iandchasse/silkscreen-enclosures/enclosures/OPEN-WORK.md

# Open work (as of 2026-10-21)

What is built but not printed, what is unproven, and the options that are studied but parked. The case READMEs have
the full records; the study notes named here are local (not in git).

## The slide-on cover (2026-11-01, round 3): checked in CAD, the phase-3 cover not printed

A reversible TI-84 style cover, one printed part per envelope (`enclosures/cover/`; `print/cover/`, `print/silkscreen-cover-plates.3mf`, a
**temporary** plate file with one cover per plate): on the front it carries the reader over the screen, on the back it stays on while
reading. Round 1's fit coupon A was printed and "feels fine" (Ian, 2026-11-01); round 2 added the Silkscreen logo engraved on the outer face
(with the two-colour switch, OFF), rounded edges, all four poses, no long stop wall (corner pieces only) and a scalloped side. Everything else
about it is **untested**: Ian printed the phase-2 cover ("the fit isn't quite there") and phase 3 answers that, but nothing of phase 3 is printed, and the snap forces are beam estimates. What Ian still decides or has to find out:
- **Putting the covers into the case plate files** (make_plates.py, every per-configuration project; not started: the worktree's `out/` lacks the other builds' print parts and the 4.26 pipeline cache is cold at its path; the cover-only plate file stays the temporary one until then);
- print one cover and check the fit, the click, the scallop's finger room, the rounded edges and (if wanted) the two-colour switch in the CC2's
  slicer (the CLI read-back is the only test so far);
- phase 2 (2026-11-01): the plate is solid over the screen (rest gap to the glass 1.37 mm; my estimate of the press that touches it: 155 N keyed, 98 N chinless, 225 N on the 3.68),
  two engraved border lines, a rounded-tongue tab inside phase 1's footprint, a uniform slit with a round end; no sharp edge is left on the covers but the engraving rims (logo and border lines);
  the cover gained about 4 to 6 g and 8 to 14 minutes for the solid plate and the lines;
- the scallop is limited by the screen (2.4 mm inset on the 4.26, 3.0 on the 3.68; 2.0 mm of plate stays past the screen opening): more would
  uncover display;
- the corner extensions are 4.7 mm (4.2 on the 3.68), set by the scallop's ease and the finger margin; a longer contact patch would shorten the ease;
- J6 is covered by the end wall in every pose (a window would have to be in the prong's zone one way up); the cover comes off to use it;
- phase 3 (2026-11-01, answering Ian's print of phase 2): the border is a rounded rectangle centring the logos; the room top to bottom (Y) at home is 0.234 mm (was 0.338) on the 4.26 and 0.165 mm on the 3.68 (channel walls 0.20 / 0.15 per side, corner pieces 0.14 / 0.12 off the arcs); the snap is firmer (pull-off peak +22 % by the beam model, push-on +6 %, drag +13 %).
  **Risk:** printing takes clearance off a gap (round 1's note: 0.1 to 0.3 per side, not measured), so the tighter fit may bind and need a pass with a file: the one number to move is `cy` in `enclosures/cover/model.py`;
- no Z clamp (0.70 mm of Z play, 0.709 measured);
- whether the site offers it (`print/SITE-BUILDER-NOTE.md` says not until a whole cover has been printed).

## Emily B's edit (2026-10-23): what Ian still decides

The six changes Ian took are in both cases (`case-426/README.md`, "Emily B's edit"). Left for Ian:
- **The side gate's 0.2 mm top chamfer.** It was drawn to end level with the old seam V (`GATE['top_chamfer']`, both cases) and
  was kept: it is a separate part and squaring it reprints the gate and touches the gate checks. Set it to 0 if he wants it square.
- **The two-colour logo switch** (2026-10-24; every lid carries the logo bodies as modifier parts, off by default; no separate
  files any more): whether the site tells its users about the switch (`print/README.md`, "Two-colour logo"); and the clicks in
  ElegooSlicer (the CC2's slicer), which are untested there (the OrcaSlicer 2.4 CLI reads the switch back; its GUI was not opened).
- **The pin tip at -1.00** (the plan said -0.90, a layer's mid-plane on the midplate's print; -1.00 is whole layers and lays where the
  barbs' tip laid).
- **Emily B's (mixmastermouse) questions:** which of the five side keys click on their lid (their nub cut-back, not taken); a photo
  of their bulge (their shorter lid posts, flat H5 pin and removed battery springs: a smaller version was taken on 2026-10-24, the
  4.26 lid's H2, H5 and H6 posts one layer short and the dead midplate spring at J6 dropped; `case-426/README.md`, "The lid's bulge
  and the board's posts"; model estimates, not measured on a print, so a photo of a real bulge still decides whether more is worth
  doing); their screws; and that their tub has the old USB edge. The credit is given (the READMEs name Emily).
- **Behind the bulge fix, on record, not done:** the midplate springs' 0.6 mm travel is narrower than the stack's tolerance window
  (every spring is free in the thinnest corner, the two lower strips bottom out on a thick panel with a thick print), and `usb_fit`
  puts the board on the H3 / H4 posts although the springs push it back at J1. Both are today's, not the community edit's.

## The 3.68 lid: rebuilt, not printed

Ian printed 5ef49dc (in the pre-split history; four screws): all four screws bite, but the lid bulged at the top middle (CAD +X, upper
middle), would not go fully down, and its long edges could be pried open. The study round and its fixes are in
`case-368/README.md` ("The battery bay (2026-10-19)"). Done, all lid only (read-backs in `bayread.py`, each shown
FAILing on the old lid and PASSing on the new one):
- The bay is one layer deeper (the back is 1.0 thick; the case is 12.9 mm, light strip 13.7), the lip is raised over a
  6.02 mm cell (a 5.3 mm cell with two layers of tape on each face), the hooks are gone.
- The lead has a route: one strip of tape on the midplate's bare back above the battery connector (J5; the tape point), a coil well beside
  it, the top rib lowered to a fence, the backstops moved 3.45 mm past the board's cut and 0.33 mm under the midplate.
- Six internal ribs (bed 3.0) and thicker latch arms (1.3 at the root, today's section from Z -0.5 up): the springs'
  bow 0.148 -> 0.113 mm in the grillage model, the long edges let go at 19-22.5 N instead of 12-16 N. Ian asked for
  1.2 / 0.85 arms; `lid_close` showed 6 of 12 meeting the board's edge, so they are thick only below the board.
- Logo and grip grooves 0.2 deep (a layer's mid-plane flips between slices; whole layers do not).

Unproven (nothing is printed):
- That Ian's lid crept (PLA under 10 N of springs and a pinched lead), or that a board sliver or the 3V3 wire sat on
  the old posts past the cut. Ask him for the checks in the plan: lid alone on a table (rocks?), the old posts' tops
  (a shiny dent?) and the wire there, the back pressed with the cell out.
- The lead's reach (a limp string, 10 % slack, the lid stood up at 90 degrees), the ribs and arms on a printer.
- Next, if the new lid still bulges: ask for a photo of the top edge. (The bigger options for the long sides are in the
  next section.)

## The 3.68's long sides (2026-10-21): the tub-only fix, merged

Ian: with all four screws in, each long side is closed at the screws and bows open in the middle between them. The
study round (cause, cause-check, a stack study and alternatives, with their checks) found one proven rigid chain and no
proven cause. The board is clamped line to line at its two bottom mounting holes (H3/H4) between the tub's bosses (printed 1.67) and the lid's posts
(0.07 at home): 1.600 of room for a 1.600 board, 8.25 mm above the bottom corner screws with no screw through it (the
4.26's go through), so any extra thickness levers the lid open along its long sides (0.07-0.10 mm per 0.1 mm of extra;
models, +-30 % to 2x). Candidates still open: the long-edge latches not holding, a lid or tub that took a set, the
lever. The cell is ruled out (it does not touch the bay lid: 1.1 mm of air).
- **Ian chose the invisible change first (2026-10-20):** the tub's H3/H4 boss faces two layers (0.4) lower
  (`params.H34_FLOAT`, `H34_FACE` 2.07), so the board floats: 0.40 of room to the bosses as printed, 0.24 with a +0.16
  board. **The midplate is the first stop, not the bosses:** its back (CAD 1.80) is 0.13 in front of the board at its
  bottom edge (0.03 with a thick panel), so that is the board's real float; a board more than about +0.13 thick still
  props the lid until the parked +0.4 spring room (option 3 below) is built. `board_room` reads only the bosses. Built
  with `asprinted.board_room` (FAILs on the old tub at 0.000, PASSes now), both builds, the plate file and the configs;
  only the tub (and the gate coupons, by 0.02 mm3) changed. **Reprint the tub only.** See `case-368/README.md`,
  "The long sides".
- **If the sides still bow, the parked options** (studied, not built; the study's plan, local, has the specs):
  1. **S5 / S6: a 5th and 6th M2 x 8 screw in the middle of each long side**, at CAD (-1.85, 26) and (61.85, 24) in place
     of the left-26 and right-24 latch arms: new tub bosses (wall carried into the latch channel, stopping 0.45 off the
     board's edge; pilot 1.7; a lead-in chamfer), lid posts from the floor to the seam, counterbores 4.2 wide and 2.0
     deep (seat at bed 2.0), midplate unchanged (its 1.6 notches clear the bosses). It holds the sides whatever the
     cause is (gap 3-10 times smaller in both models). Visible: two more heads a third of the way up each edge, and the
     back's round notched about 4 mm at each (show Ian first); a socket head sits flush with zero margin. Every 3.68
     configuration changes together (old lid on a new tub does not close). New read-backs: S5/S6 screws, rim-to-tub, the
     bosses' X clearance, `lid_close`, `midplane_ties`.
  2. **A bigger cell** (only if Ian wants more than 500 mAh): a 403048 (4.0 x 30 x 48, about 600 mAh; Enerforce
     LP403048 is 3.85 thick but has a Molex 5264 plug, a generic one a PH2.0) lying over the ESP32 shield, in a lid whose
     pocket moves there: about 13.3 mm (12.9 with a looser air rule) for a cell of at most 4.0, 13.7 for any "4 mm" cell
     up to 4.3. Needs the RF pre-test first (today's cell flat on the shield with paper under it, Wi-Fi sync with and
     without), its own design pass and read-backs. A 403450 does not fit; the 503035 does not suit that pocket.
  3. **+0.4 spring room** (MID_REAR +0.4: tub, midplate and the four bottom keys reprinted, 13.3 mm) only if Ian's
     checks show a solid stack. It is also what lets a board thicker than +0.13 (+0.03 with a thick panel) float.
  - The 4-layer case (a seat frame between the board and a tray lid) was studied and not recommended: it keeps the same
    latches and tongue, and its frame and lid are about half as stiff along the long edges.
  - Checks for Ian that decide between the candidates (no tools): press the middle of each long side (click and stay, or
    spring back); back the two bottom screws out two turns and press again (do the middles close?); lid alone on a flat
    table and tub alone face down (rock?); a shiny dent on the lid's two bottom posts or the tub's bosses; whether the
    GND bodge wire lies on C6 (the 3.3 V regulator's output capacitor, one end of that wire).
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
