iandchasse/silkscreen-enclosures/showcase/API.md

# Silkscreen showcase: data contract and page API

One case-centric page for both case sizes (4.26" and 3.68") and both builds (standard and light strip). It keeps
the Rev K showcase's layout: a sticky 3D stage with part chips, explode, section, press, Play assembly, and a tour
of mechanism cards with live section drawings. The light strip is one card, placed right after the bottom-keys card.

The source of truth for everything in sections 1-3 is `gen/sc_contract.py` (schema, tables and validator). This
file explains it. If the two disagree, the code wins; fix this file.

**Rebuilding the page (since the 2026-09-28 restructure).** The case projects are `enclosures/case-426` and
`enclosures/case-368`, and their print files are in the repo's `print/4.26/` and `print/3.68/`. After a case build, run
each adapter from its project folder with that project's Python (`$py426` and `$py368` below: a Python 3.11 virtual
environment made from that project's `requirements.txt`), then the bundler from the repo root:

```powershell
cd enclosures\case-426; & $py426 -B ..\..\showcase\gen\adapt_426.py
cd ..\case-368;        & $py368 -B ..\..\showcase\gen\adapt_368.py
cd ..\..;              python -B showcase\gen\bundle.py --strict-page      # add --mirror DIR for a copy to publish
```
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
