iandchasse/silkscreen-enclosures/docs/images/color-front-lines-chinless.png

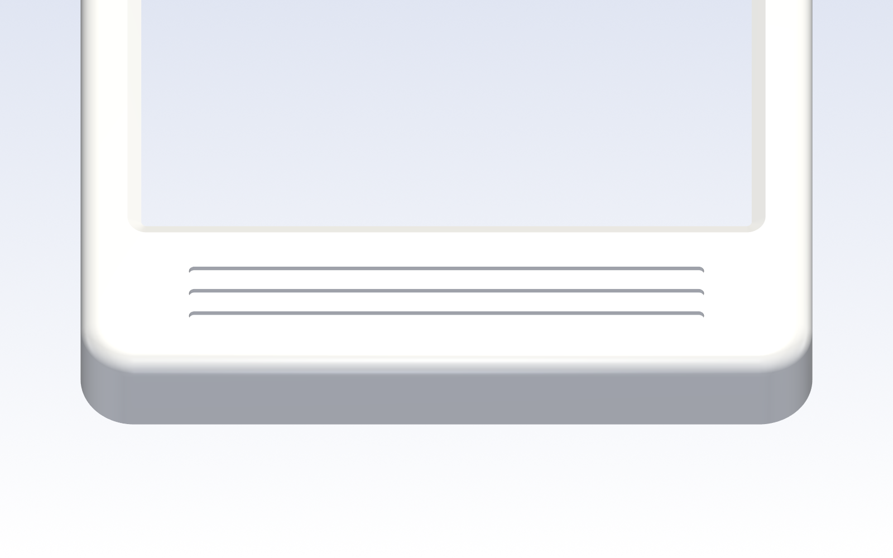
docs/images/color-front-lines-chinless.png
