iandchasse/silkscreen-enclosures/docs/images/color-front-lines.png

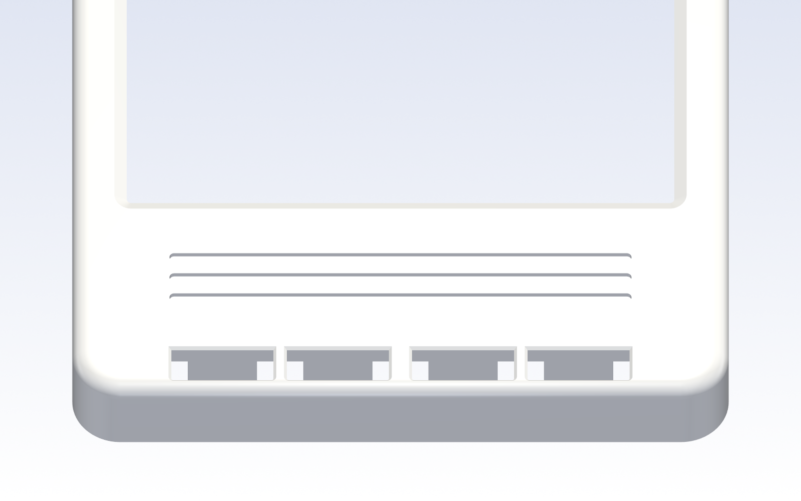
docs/images/color-front-lines.png
