iandchasse/silkscreen-enclosures/docs/images/optics_heatmaps.png

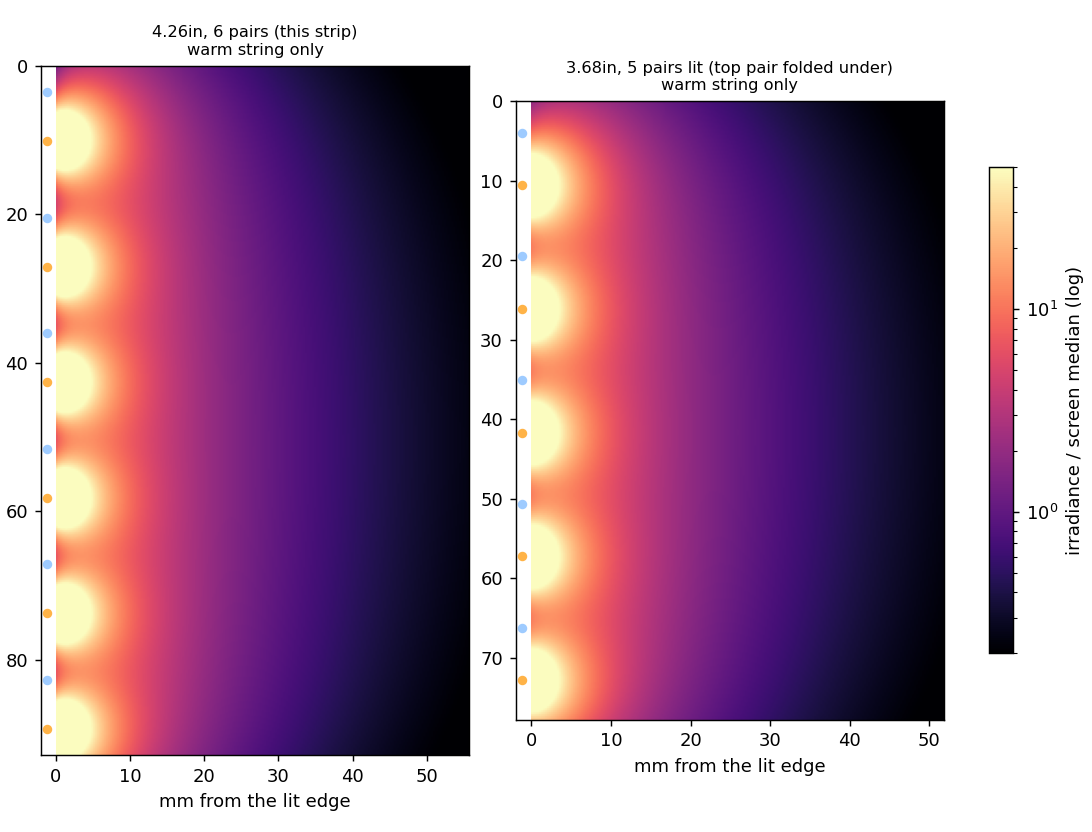
docs/images/optics_heatmaps.png
