iandchasse/silkscreen-enclosures/enclosures/case-368/hardware/battery-connected-mm.stl

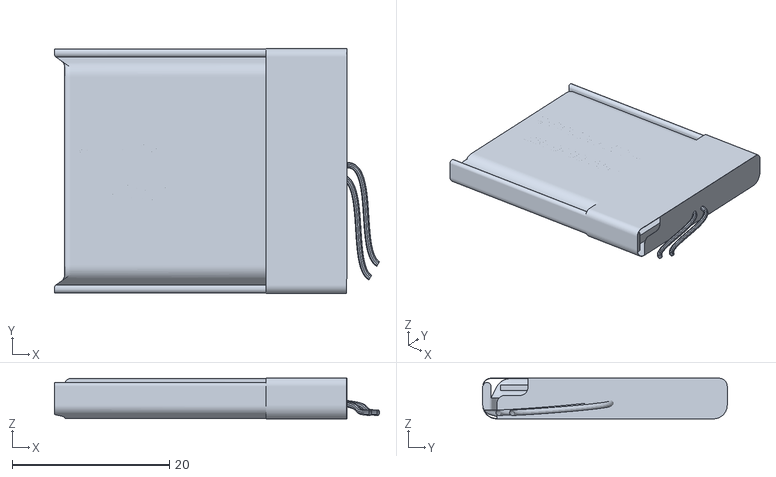
[picture p21: CAD file, 2026-10-21]
enclosures/case-368/hardware/battery-connected-mm.stl
41.3 x 31.1 x 5.17
