iandchasse/silkscreen-enclosures/enclosures/case-368/hardware/reference/j7/pcb-2026-09-16-solid-mm.step

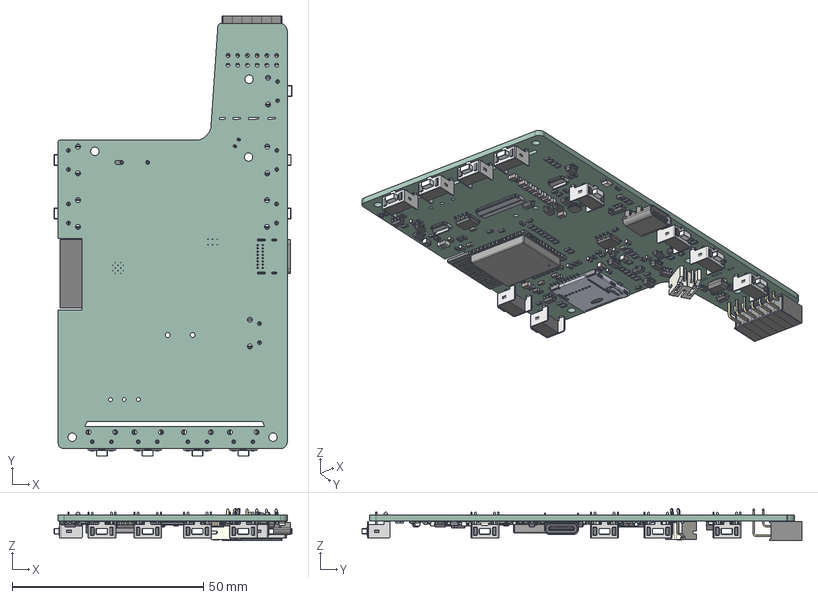
[picture p22: CAD file, 2026-10-21]
enclosures/case-368/hardware/reference/j7/pcb-2026-09-16-solid-mm.step
62.2 x 115.1 x 8.48 mm
C_0603_1608Metric x 22
R_0603_1608Metric x 78
C_0805_2012Metric x 13
SOT-23-6 x 7
PPPC022LJBN-RC_C06
Pin - Gold x 6
MJTP1117 x 10
SOT-583-8
SOT-23 x 6
SOT-23-5 x 2
L_1008_2520Metric
D_SOD-323 x 3
ESP32-S3-WROOM-1
SOT-323_SC-70
sot563_body
sot563_pin x 6
JST_PH_S2B-PH-K_1x02_P2.00mm_Horizontal
SOIC-8-1EP_3.9x4.9mm_P1.27mm_EP2.29x3mm
D_SOD-123 x 3
TF-SMD_TF-PUSH
MEM2075-00-140-01-A
USB_C_Receptacle_GCT_USB4085
LED_1206_3216Metric
FH34SRJ-24S-0.5SH
FH34SRJ-6S_ACTUATOROPEN.PRT x 2
Fuse_0805_2012Metric
SRN3010C-100M
D_SMA
SOIC-8_3.9x4.9mm_P1.27mm
silkscreen-portable_PCB
