iandchasse/silkscreen-enclosures/enclosures/cover/ref/phase2-210915c-keyed-prong.stl

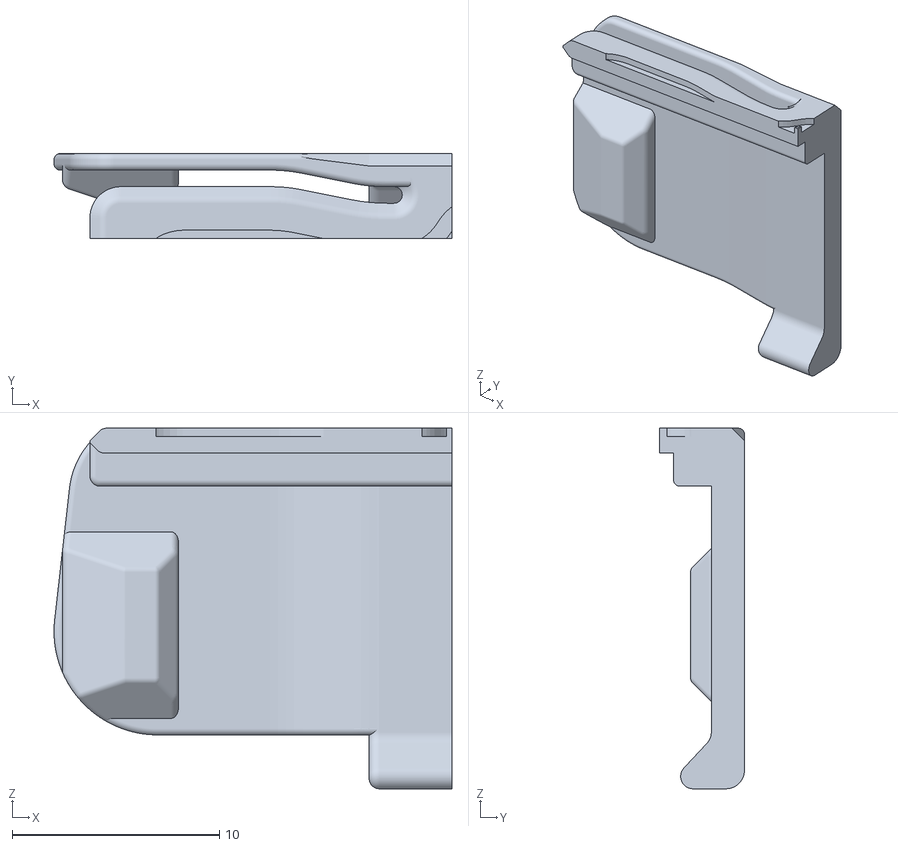
[picture p23: CAD file, 2026-11-02]
enclosures/cover/ref/phase2-210915c-keyed-prong.stl
19.2 x 4.10 x 17.4
