iandchasse/silkscreen-enclosures/print/3.68/lid-inlay-icon.step

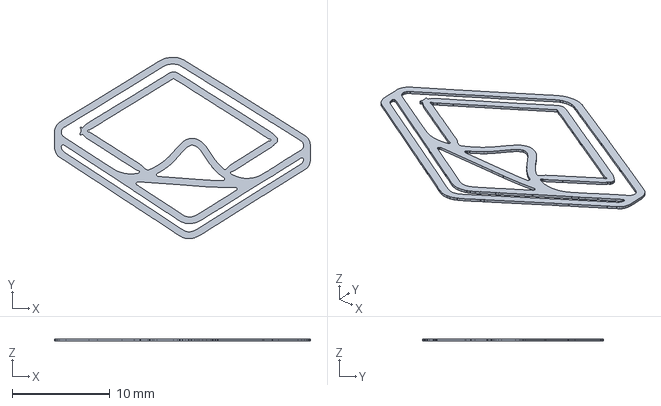
[picture p24: CAD file, 2026-11-08]
print/3.68/lid-inlay-icon.step
26.2 x 18.6 x 0.2 mm
