iandchasse/silkscreen-enclosures/print/4.26/lid-chinless.step

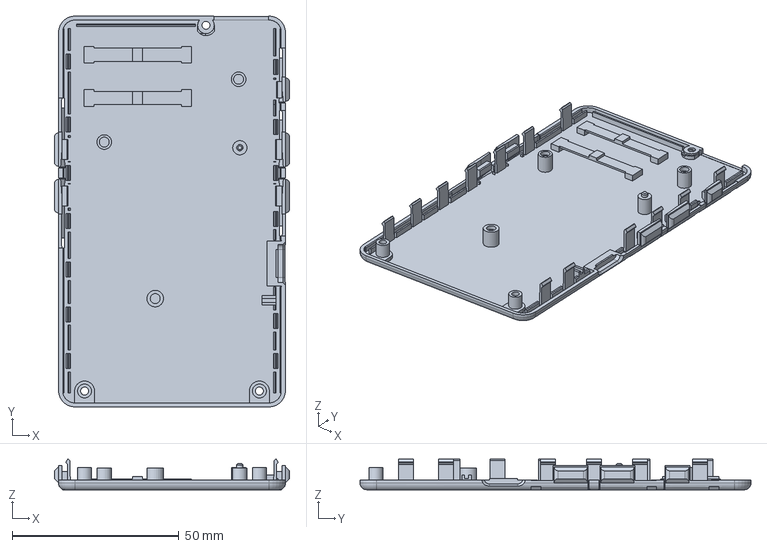
[picture p25: CAD file, 2026-11-08]
print/4.26/lid-chinless.step
70.6 x 117.4 x 9.19 mm
