iandchasse/silkscreen-enclosures/print/cover/3.68/cover-standard-inlay-wordmark.stl

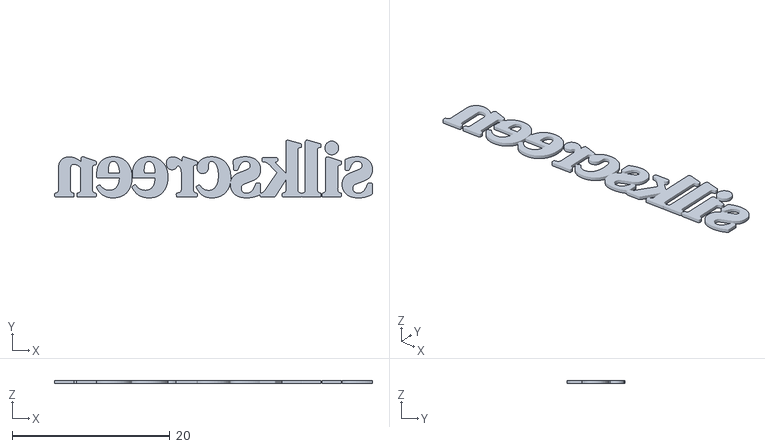
[picture p26: CAD file, 2026-11-08]
print/cover/3.68/cover-standard-inlay-wordmark.stl
40.3 x 7.35 x 0.4
