iandchasse/silkscreen-enclosures/print/silkscreen-368-plates.3mf

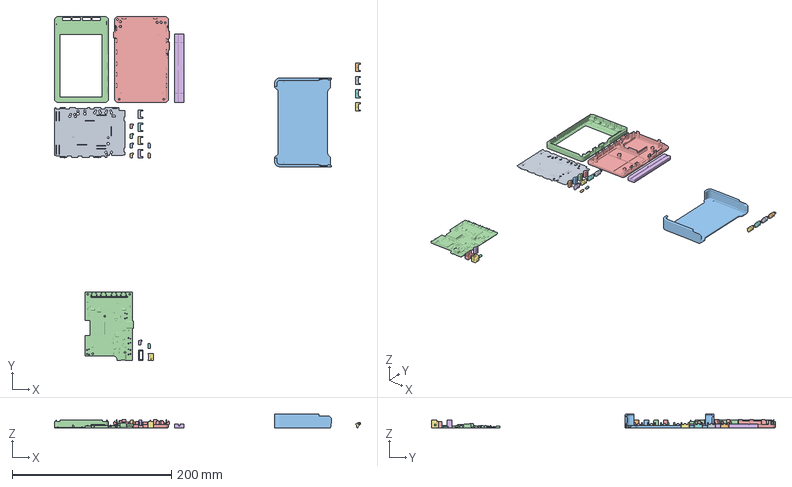
[picture p27: CAD file, 2026-11-08]
print/silkscreen-368-plates.3mf
384.5 x 431.8 x 17.8 mm
midplate
key-x3std 1
key-x3std 2
key-x3std 3
key-x3std 4
crank-T 1 - TS365ZJ, JLC boards
crank-T 2 - TS365ZJ, JLC boards
crank-T 3 - TS365ZJ, JLC boards
crank-T 4 - TS365ZJ, JLC boards
gate 1
gate 2 (spare)
tub
lid
rod jig (straighten and cut the rod)
crank-M 1 - APEM MJTP1117 only
crank-M 2 - APEM MJTP1117 only
crank-M 3 - APEM MJTP1117 only
crank-M 4 - APEM MJTP1117 only
slide cover (3.68)
pcba-dummy (test fit)
coupon-strip
key-x3std (for the coupon strip)
coupon-gate
gate (for the gate coupon)
