iandchasse/silkscreen-enclosures/enclosures/case-368/hardware/board.step

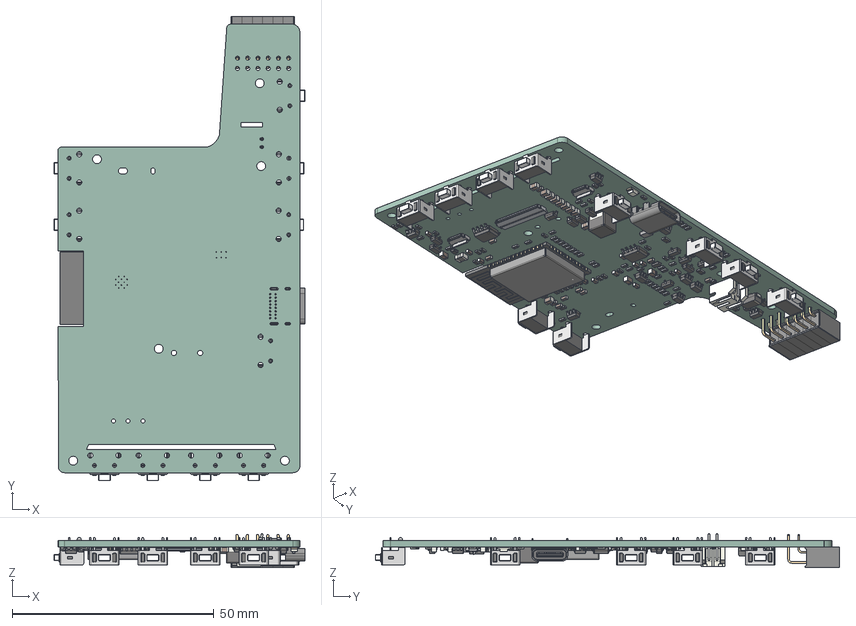
[picture p28: CAD file, 2026-10-21]
enclosures/case-368/hardware/board.step
62.2 x 115.1 x 8.48 mm
C_0603_1608Metric x 23
R_0603_1608Metric x 76
C_0805_2012Metric x 13
SOT-23-6 x 7
PPPC022LJBN-RC_C06
Pin - Gold x 6
MJTP1117 x 10
SOT-583-8
SOT-23 x 8
Fuse_0805_2012Metric x 2
SOT-23-5 x 2
L_1008_2520Metric
D_SOD-323 x 2
D_SMF
ESP32-S3-WROOM-1
SOT-323_SC-70
sot563_body
sot563_pin x 6
JST_PH_S2B-PH-K_1x02_P2.00mm_Horizontal
SOIC-8-1EP_3.9x4.9mm_P1.27mm_EP2.29x3mm
R_0805_2012Metric
D_SOD-123 x 3
TF-SMD_TF-PUSH
USB_C_Receptacle_GCT_USB4085
LED_1206_3216Metric
FH34SRJ-24S-0.5SH
FH34SRJ-6S_ACTUATOROPEN.PRT x 2
L_APV_ANR5040
D_SMA
SOIC-8_3.9x4.9mm_P1.27mm
silkscreen_pcb-portable_PCB
