iandchasse/silkscreen-enclosures/print/4.26/lid-inlay-icon.step

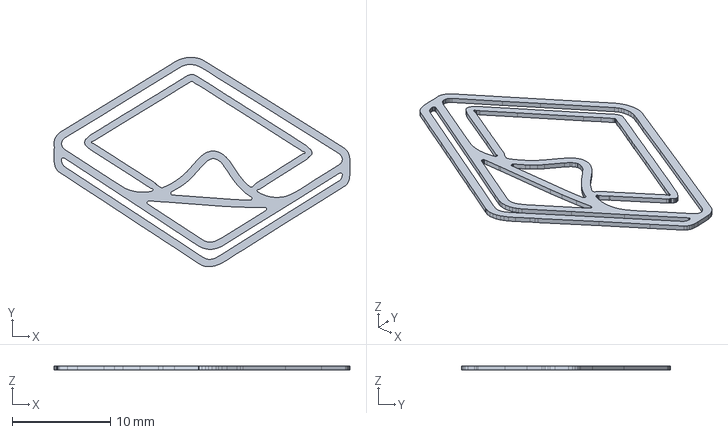
[picture p29: CAD file, 2026-11-08]
print/4.26/lid-inlay-icon.step
30.2 x 21.4 x 0.4 mm
