iandchasse/silkscreen-enclosures/print/cover/3.68/cover-standard.step

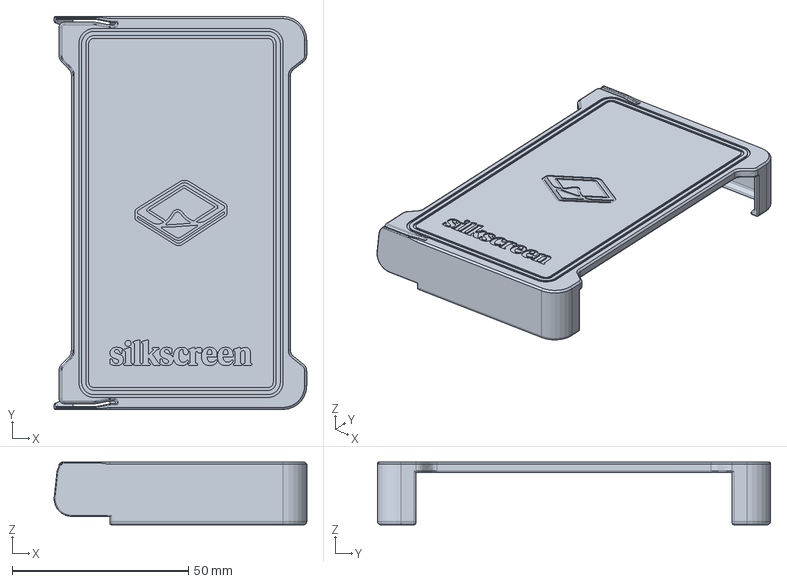
[picture p30: CAD file, 2026-11-08]
print/cover/3.68/cover-standard.step
71.6 x 111.5 x 17.8 mm
