iandchasse/silkscreen-enclosures/print/silkscreen-426-plates.3mf

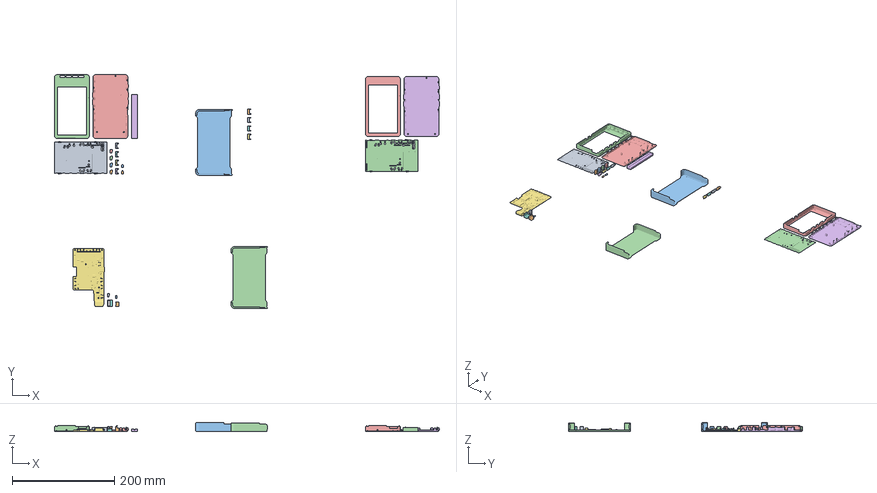
[picture p31: CAD file, 2026-11-08]
print/silkscreen-426-plates.3mf
753.8 x 457.7 x 17.4 mm
midplate x 2
key-426 1
key-426 2
key-426 3
key-426 4
crank-T 1 - TS365ZJ, JLC boards
crank-T 2 - TS365ZJ, JLC boards
crank-T 3 - TS365ZJ, JLC boards
crank-T 4 - TS365ZJ, JLC boards
gate 1
gate 2 (spare)
tub x 2
lid x 2
rod jig (straighten and cut the rod)
crank-M 1 - APEM MJTP1117 only
crank-M 2 - APEM MJTP1117 only
crank-M 3 - APEM MJTP1117 only
crank-M 4 - APEM MJTP1117 only
slide cover (bottom keys)
pcba-dummy (test fit)
coupon-chin
key-426 (for the chin coupon)
coupon-gate
gate (for the gate coupon)
slide cover (chinless)
