iandchasse/silkscreen-enclosures/print/3.68/lid.step

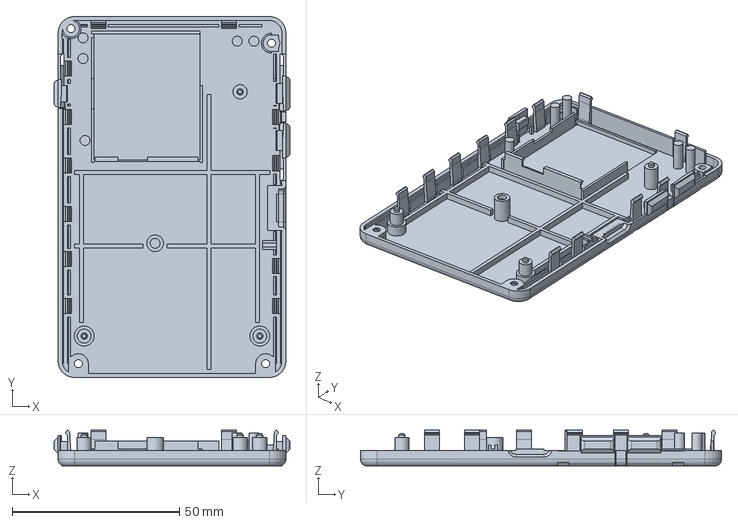
[picture p32: CAD file, 2026-11-08]
print/3.68/lid.step
70.6 x 108.0 x 10.7 mm
