iandchasse/silkscreen-enclosures/print/silkscreen-cover-plates.3mf

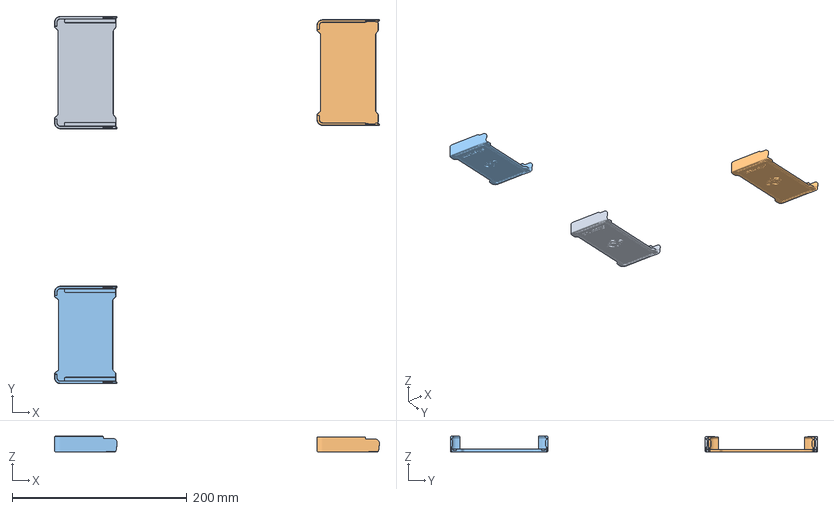
[picture p33: CAD file, 2026-11-08]
print/silkscreen-cover-plates.3mf
371.7 x 420.1 x 17.8 mm
cover-keyed (4.26, bottom keys)
cover-chinless (4.26)
cover-standard (3.68)
