iandchasse/silkscreen-enclosures/print/3.68/tub-front-lines.stl

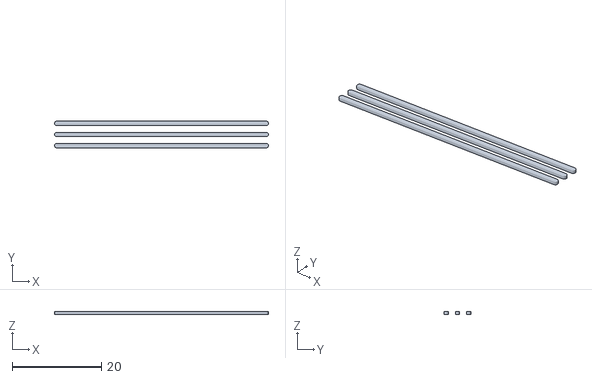
[picture p34: CAD file, 2026-11-07]
print/3.68/tub-front-lines.stl
48.0 x 6.00 x 0.6
