iandchasse/silkscreen-enclosures/print/rod-jig.step

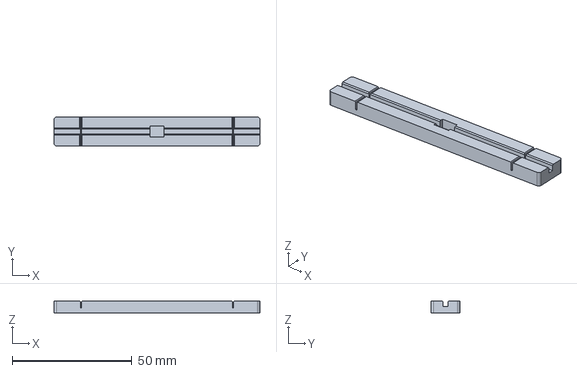
[picture p35: CAD file, 2026-10-21]
print/rod-jig.step
86.0 x 12.0 x 5.00 mm
