iandchasse/silkscreen-enclosures/print/3.68/tub-standard.step

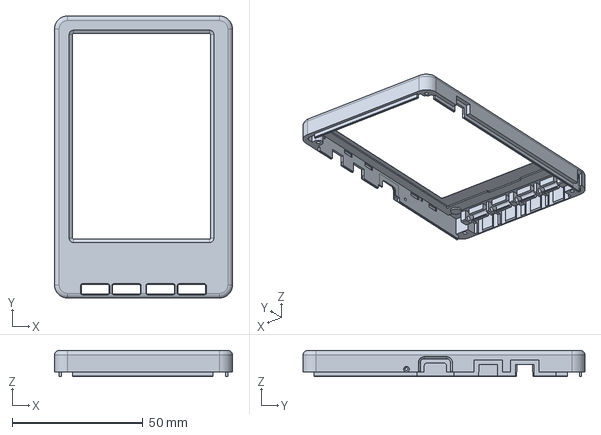
[picture p36: CAD file, 2026-10-23]
print/3.68/tub-standard.step
68.2 x 108.0 x 10.0 mm
