iandchasse/silkscreen-enclosures/print/4.26/lid.step

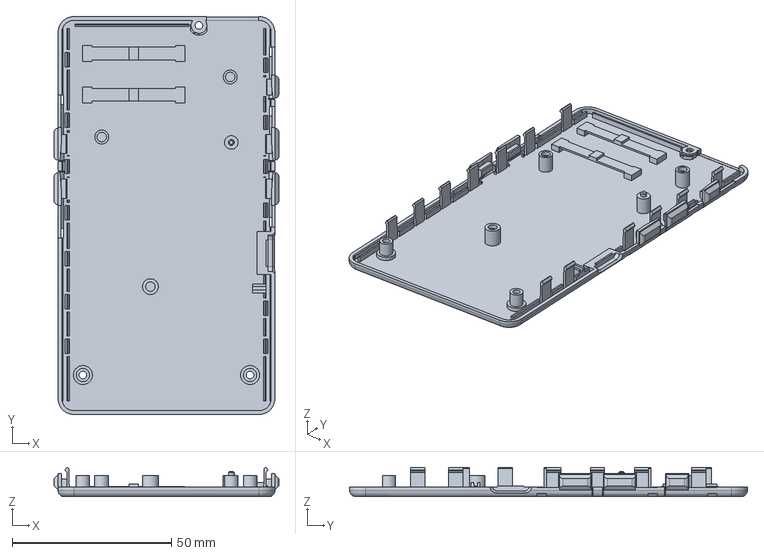
[picture p37: CAD file, 2026-11-08]
print/4.26/lid.step
70.6 x 125.0 x 9.19 mm
