iandchasse/silkscreen-enclosures/print/cover/4.26/cover-keyed.step

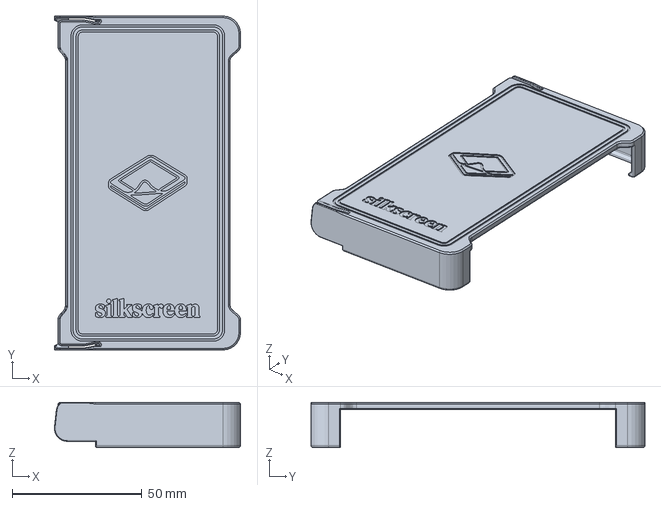
[picture p38: CAD file, 2026-11-08]
print/cover/4.26/cover-keyed.step
71.6 x 128.6 x 17.4 mm
