iandchasse/silkscreen-enclosures/print/cover/4.26/cover-chinless.step

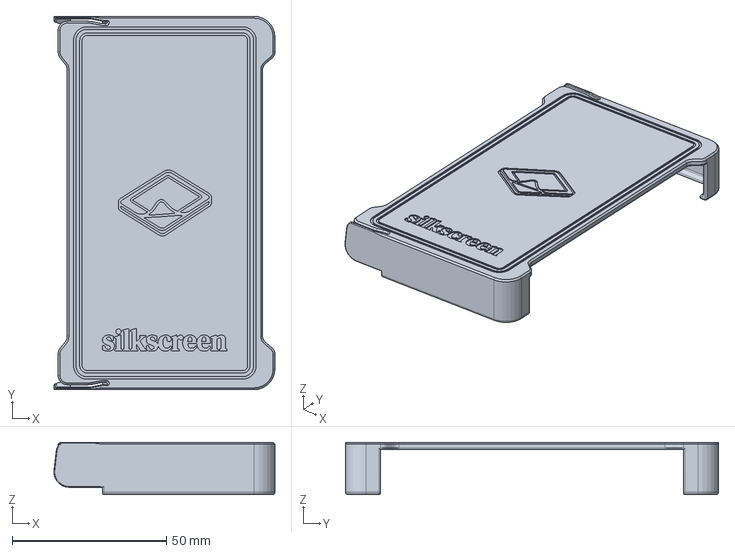
[picture p40: CAD file, 2026-11-08]
print/cover/4.26/cover-chinless.step
71.6 x 121.0 x 17.0 mm
