iandchasse/silkscreen-enclosures/print/3.68/tub-light-strip.step

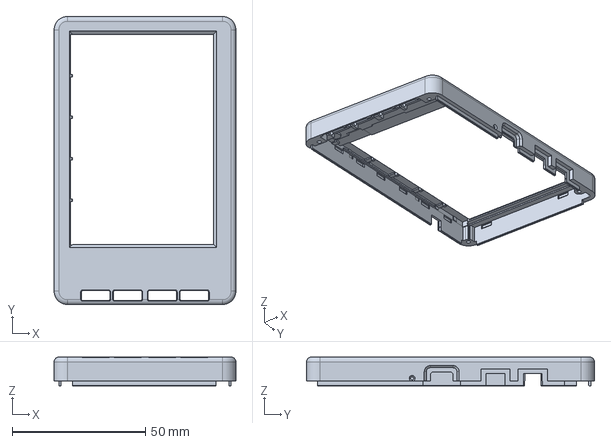
[picture p41: CAD file, 2026-10-23]
print/3.68/tub-light-strip.step
68.2 x 108.0 x 10.8 mm
