iandchasse/silkscreen-enclosures/print/3.68/midplate.step

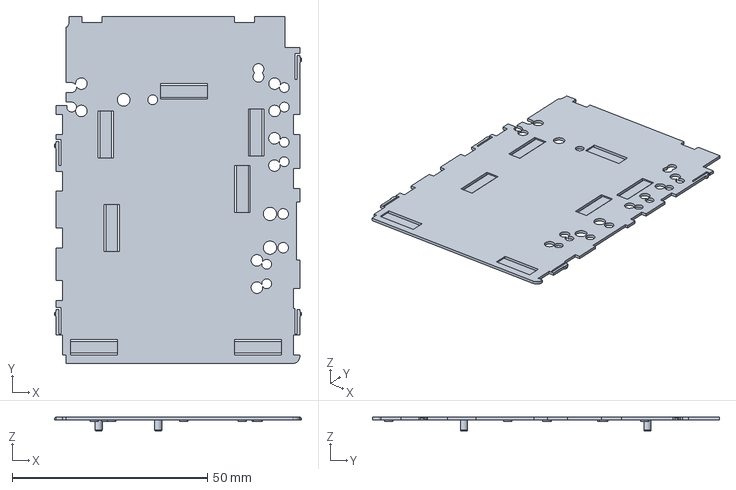
[picture p42: CAD file, 2026-10-23]
print/3.68/midplate.step
63.3 x 88.9 x 3.60 mm
