iandchasse/silkscreen-enclosures/print/3.68/coupon-gate-x3std.step

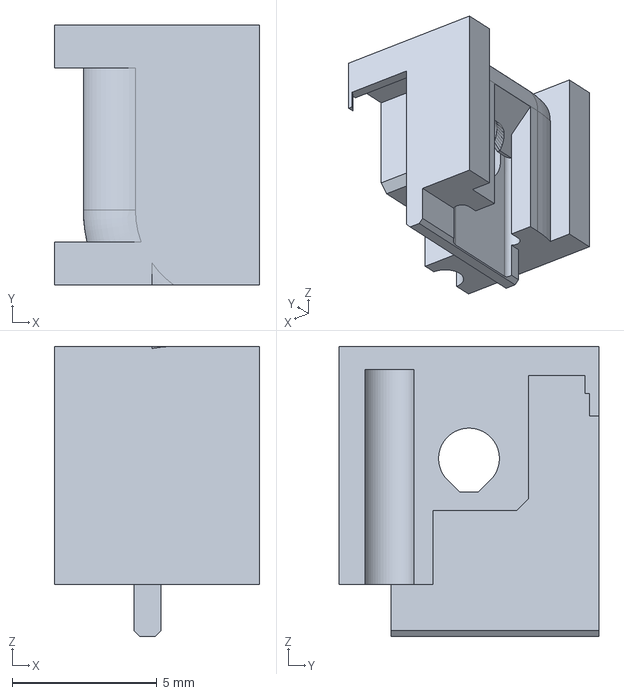
[picture p43: CAD file, 2026-10-23]
print/3.68/coupon-gate-x3std.step
7.09 x 9.00 x 10.0 mm
