iandchasse/silkscreen-enclosures/print/4.26/midplate.step

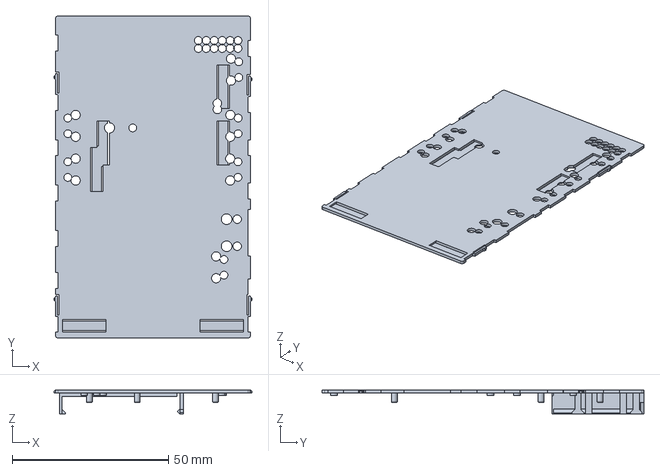
[picture p44: CAD file, 2026-10-24]
print/4.26/midplate.step
63.3 x 103.1 x 7.64 mm
