iandchasse/silkscreen-enclosures/print/3.68/coupon-strip-x3ls.step

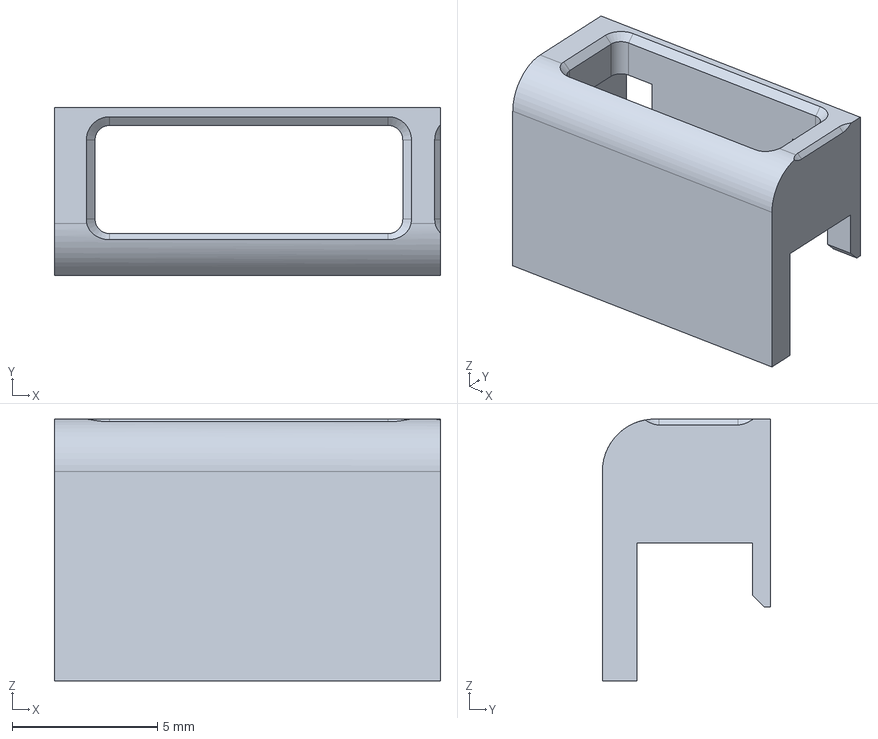
[picture p45: CAD file, 2026-10-23]
print/3.68/coupon-strip-x3ls.step
13.3 x 5.80 x 9.02 mm
