iandchasse/silkscreen-enclosures/print/4.26/coupon-chin.step

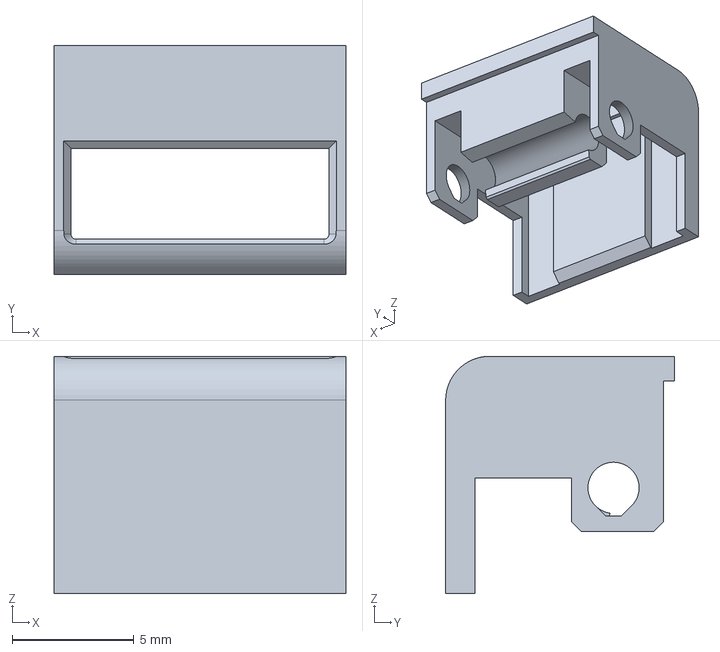
[picture p46: CAD file, 2026-10-24]
print/4.26/coupon-chin.step
12.0 x 9.40 x 9.75 mm
