iandchasse/silkscreen-enclosures/print/3.68/coupon-strip-x3std.step

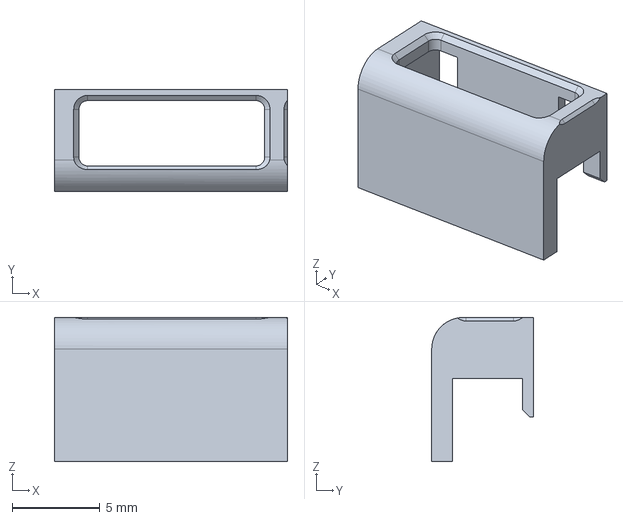
[picture p47: CAD file, 2026-10-23]
print/3.68/coupon-strip-x3std.step
13.3 x 5.80 x 8.22 mm
