iandchasse/silkscreen-enclosures/print/4.26/tub-chinless.step

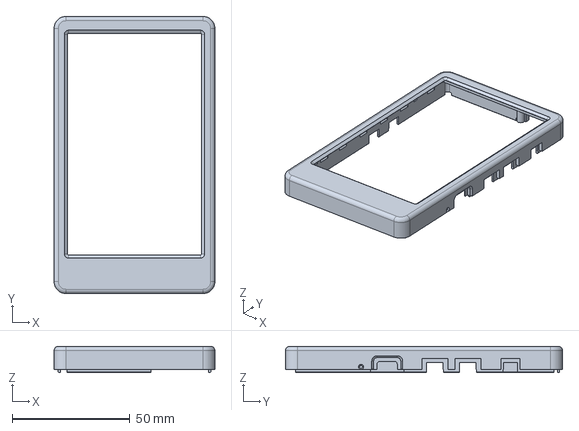
[picture p48: CAD file, 2026-10-24]
print/4.26/tub-chinless.step
68.2 x 117.4 x 11.2 mm
