iandchasse/silkscreen-enclosures/print/3.68/gate.step

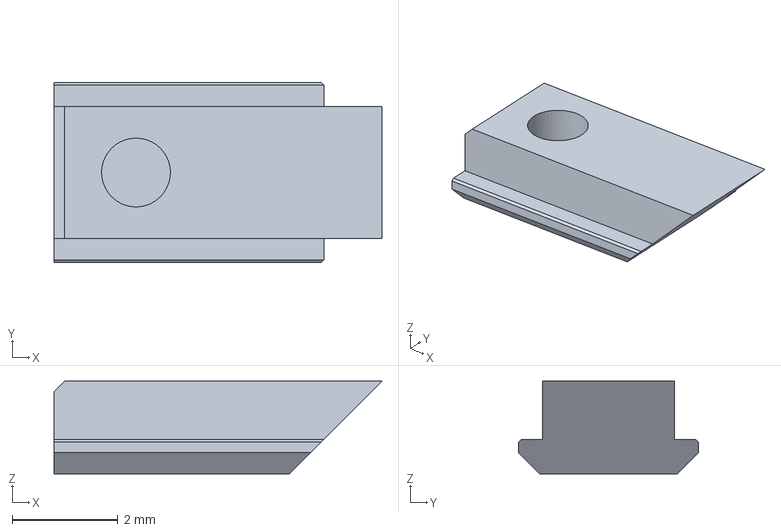
[picture p49: CAD file, 2026-10-21]
print/3.68/gate.step
6.20 x 3.40 x 1.75 mm
