iandchasse/silkscreen-enclosures/print/4.26/tub-standard.step

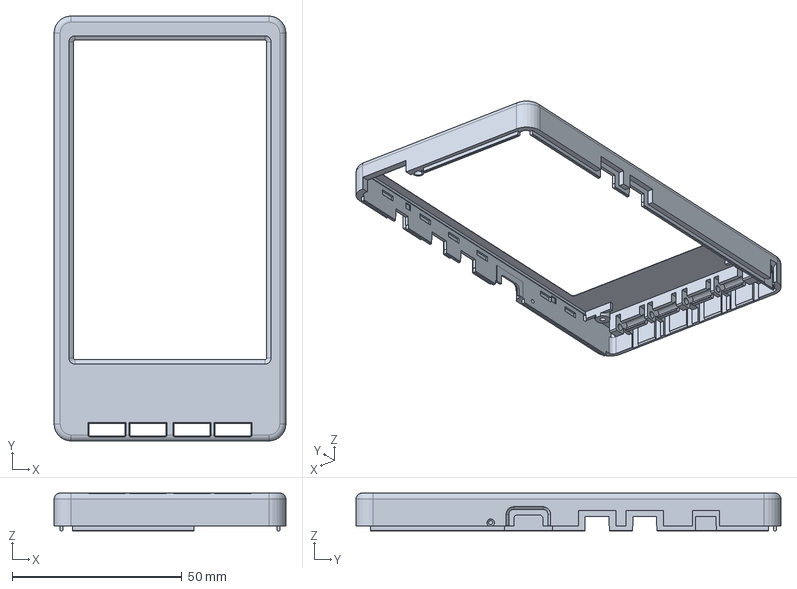
[picture p50: CAD file, 2026-10-24]
print/4.26/tub-standard.step
68.2 x 125.0 x 11.2 mm
