iandchasse/silkscreen-enclosures/print/3.68/key-x3ls.step

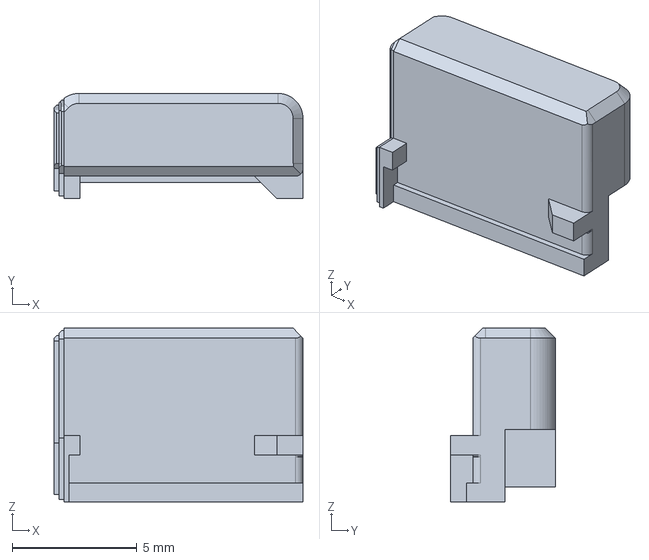
[picture p51: CAD file, 2026-10-21]
print/3.68/key-x3ls.step
10.0 x 4.22 x 6.97 mm
