iandchasse/silkscreen-enclosures/print/3.68/key-x3std.step

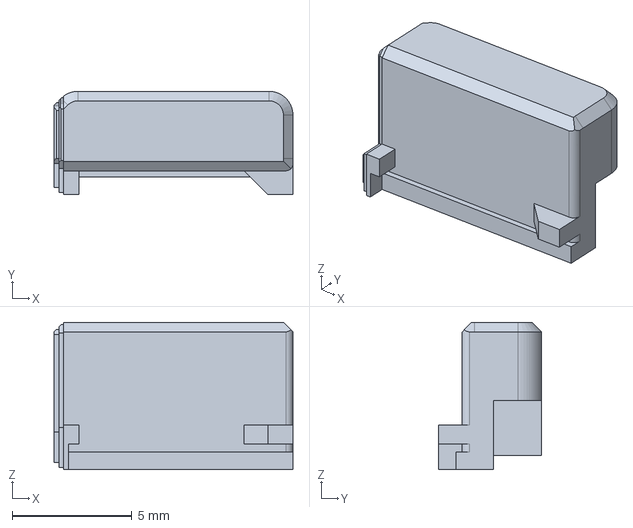
[picture p53: CAD file, 2026-10-21]
print/3.68/key-x3std.step
10.0 x 4.33 x 6.17 mm
