iandchasse/silkscreen-enclosures/print/4.26/coupon-gate.step

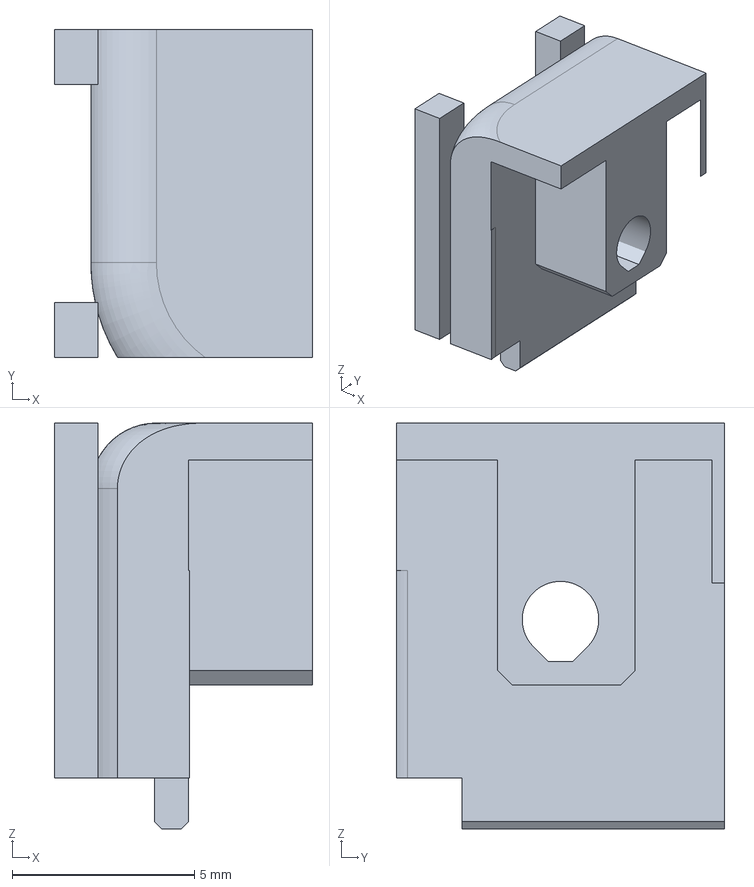
[picture p55: CAD file, 2026-10-24]
print/4.26/coupon-gate.step
7.09 x 9.00 x 11.2 mm
