iandchasse/silkscreen-enclosures/print/3.68/crank-M.step

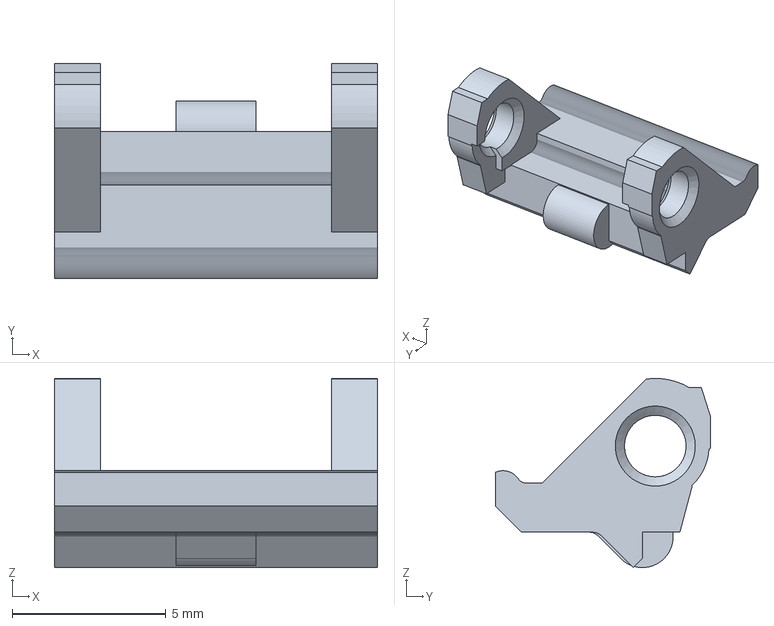
[picture p56: CAD file, 2026-10-21]
print/3.68/crank-M.step
10.5 x 7.00 x 6.15 mm
