iandchasse/silkscreen-enclosures/print/4.26/key-426.step

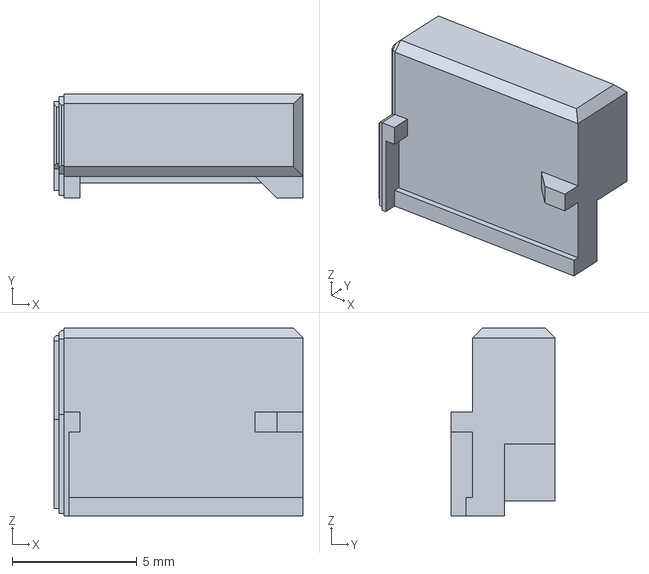
[picture p57: CAD file, 2026-10-21]
print/4.26/key-426.step
10.0 x 4.18 x 7.55 mm
