iandchasse/silkscreen-enclosures/(list of files, cad)

Other CAD files:
print/cover/4.26/cover-keyed-inlay-wordmark.stl
print/3.68/lid-inlay-wordmark.step
print/cover/4.26/cover-chinless-inlay-icon.stl
print/4.26/lid-chinless-inlay-wordmark.step
print/cover/3.68/cover-standard-inlay-icon.stl
print/cover/4.26/cover-keyed-inlay-icon.stl
print/4.26/lid-inlay-wordmark.step
print/cover/4.26/cover-chinless-inlay-wordmark.stl
print/4.26/lid-chinless-inlay-icon.step
print/4.26/tub-front-lines-chinless.stl
print/4.26/tub-front-lines.stl
print/4.26/tub-light-strip.step
print/4.26/crank-M.step
print/4.26/crank-T.step
print/4.26/gate.step
enclosures/cover/ref/old-27bbdaf-keyed.stl
print/3.68/coupon-gate-x3ls.stl
print/3.68/coupon-gate-x3std.stl
print/3.68/coupon-strip-x3ls.stl
print/3.68/coupon-strip-x3std.stl
print/3.68/crank-M.stl
print/3.68/crank-T.stl
print/3.68/gate.stl
print/3.68/key-x3ls.stl
print/3.68/key-x3std.stl
print/3.68/lid-inlay-icon.stl
print/3.68/lid-inlay-wordmark.stl
print/3.68/lid.stl
print/3.68/midplate.stl
print/3.68/tub-light-strip.stl
print/3.68/tub-standard.stl
print/4.26/coupon-chin.stl
print/4.26/coupon-gate.stl
print/4.26/crank-M.stl
print/4.26/crank-T.stl
print/4.26/gate.stl
print/4.26/key-426.stl
print/4.26/lid-chinless-inlay-icon.stl
print/4.26/lid-chinless-inlay-wordmark.stl
print/4.26/lid-chinless.stl
print/4.26/lid-inlay-icon.stl
print/4.26/lid-inlay-wordmark.stl
print/4.26/lid.stl
print/4.26/midplate.stl
print/4.26/tub-chinless.stl
print/4.26/tub-light-strip-chinless.stl
print/4.26/tub-light-strip.stl
print/4.26/tub-standard.stl
print/cover/3.68/cover-standard.stl
print/cover/4.26/cover-chinless.stl
print/cover/4.26/cover-keyed.stl
print/rod-jig.stl
