iandchasse/silkscreen-enclosures/print/README.md

# Print files

> [!IMPORTANT]
> AI-assisted, not the official Silkscreen enclosure: see the notice at the top of the
> [main README](../README.md) and https://silkscreenreader.com/ai.

Everything to print for both Silkscreen cases. The files are generated by the case projects in
[`../enclosures/`](../enclosures/): don't edit them here, rebuild them (below). If you just want to print a case with
any printer, start at the [top-level README](../README.md#print-a-case): it points to the generic OrcaSlicer projects on
the website and says what each contains.

**4.26, test 2 (2026-09-30):** the bottom keys tilted, sat low, stuck or fell out, and the cranks were out of place
until the lid went on. The keys are now **hook keys**: two rigid hooks per key run in two new slots in the tub's chin
wall and stop under the skin. The drag leaf and its bump are gone, and so are the drag coupon's keys
(`coupon-key-1` to `-4`). Nothing on the key flexes or rubs. The case README's "Bottom keys" section has the details.

**Bottom keys, 2026-10-03: the 50-layer key** (Ian: "a bit too much left-right wiggle"). The key prints on its end,
so its length across is a stack of 0.2 mm layers: at 9.9 mm the slicer dropped the last layer and printed 9.8, 0.40 mm
of play a side. It is now 10.0 mm, exactly 50 layers: 0.30 mm a side, about 0.2 mm less slide in all. Nothing else
changed, but on the 3.68 the key's two rail-side corners are rounder (R1.0, was R0.5), so they keep at least that
play too (about 0.46 mm there as sliced). If your hook keys are already printed, reprint just the 4 keys for your
size (`key-426`; on the 3.68 `key-x3std` or `key-x3ls`, the build's own) from plate 1 (the CC2 plate file's plate 1 or 2). The old keys still fit
and work if you don't.

**4.26 bottom keys, 2026-10-03: the caps sit 0.15 mm lower** (Ian: "a small fraction of a mm too high"). Face up
`key-426` now stands about 1.35 mm proud (was 1.50), and face down on its hooks about 2.4 (was 2.5). Only the cap's
top moved: the hooks, the slots, the travel and everything else are unchanged, so reprint just the 4 keys (plate 1)
to get it; the old keys still fit and work. 1.35 is the lowest the crank spec allows (at least 1.0 mm proud
with the board 0.2 mm off), and the 4.26 build now checks it. The 3.68 keys keep their height. To undo it, set
`KEY_CAP` proud back to 1.50 in `enclosures/case-426/src/params.py` and rebuild (below), or revert that commit on
its own.

**4.26 chinless case, 2026-10-04 (touch-centric, new, not printed yet):** a 4.26 case with **no bottom keys** and
the shortest chin: 117.4 mm tall instead of 125.0 (the wordmark was centred in what is left below the screen; since 2026-10-23 it is on the back). It is for
the stock touch panel (GDEQ0426T82-FT01C): touch does OK/Back, and the five side keys are as on the standard case.
**Its board must NOT have the four bottom switches (SW9, SW8, SW3, SW2) fitted:** they stick out 1.9 mm past the
board's bottom edge, into the chin wall, and the case will not close over them. Order the board without the bottom
row, or remove them. Print **plate 3 "Case: touch panel, chinless, ..."** of `silkscreen-426-plates.3mf`: `tub-chinless`, `lid-chinless`
(side keys included, with their supports set as on plate 1) and the shared `midplate`. No keys, cranks, rod,
gate or coupons, so the gate coupon is not needed either.

**4.26 light-strip chinless case, 2026-10-07 (new, not printed yet; in development, not released):** the chinless case for the plain panel with the
Silkscreen light strip: the same 117.4 mm chin, the light-strip front, and the page keys and power as its only keys
(no touch, no bottom row). The same board rule: **no bottom-row buttons (SW9, SW8, SW3, SW2)**. Print **plate 5 "Light-strip chinless
case"** of the author's CC2 plate file (`cc2-local/`, not in git): `tub-light-strip-chinless`, `lid-chinless` (the chinless case's lid: the lid does not depend on the panel)
and the shared `midplate`.

**4.26 configurations, 2026-10-07 (new, not printed yet):** the 4.26 case now comes in 32 configurations: either
panel (touch, or the light strip), with or without the bottom keys, with all four page keys or only the left pair,
the right pair or the upper pair (a key left out is the plain wall; power is on every case), and with or without
the dev header (the board's expansion header, J6). This folder keeps the four above (the *print builds*: standard,
light-strip, chinless, light-strip chinless, each with all four page keys and the dev header). Every configuration, these included, also has its own
OrcaSlicer project, made by the case project: see [Any other 4.26 configuration](#any-other-426-configuration-its-own-orcaslicer-project)
below.

**Bottom keys and cranks, 2026-10-06: on a 2-layer raft** (Ian: "maybe add 2-layer rafts to the buttons/cranks.
That's what I've been doing so that they don't unstick from the build plate"). Both plate files now put every bottom
key and every crank (the coupons' keys too) on a 2-layer raft, set per object: *Raft layers* 2, *Raft contact Z
distance* 0.2 (one 0.2 layer of air between the raft and the part, so it lifts off; Orca's default is 0.1) and the
raft's *Initial layer expansion* 1 (Orca's default 2 runs neighbouring rafts on the plate into each other). Nothing
else changed: sliced from the plate files, each key is still exactly 50 layers (10.00 mm) above its raft, and the
keys' fit, the cranks' cheeks and bores and the no-supports checks read the same as without the raft. Peel the raft
off the key's -X end or the crank's pad end; a light scrape there is fine (up to 0.1 mm of residue is within the
crank spec), but don't sand the key's end, which sets its length. The key's bed-end chamfer stays: over the raft the
first layer is laid with ordinary lines and does not flare, but the chamfer takes nothing from the fit, keeps the
first layer inside the key's outline either way, and keeps the key right if it is printed without a raft.

**4.26 screen bevel, 2026-10-10 (Ian: "go for 35 on the 4.26"; not printed yet):** the touch-panel tubs
(`tub-standard`, `tub-chinless`, and every touch configuration's) have a wider, rounded bevel round the screen: one
35-degree slope from the face down to the screen, 1.29 mm wide on the face (before: 0.6 mm at 45 degrees, then a 0.42
mm straight step at the screen's edge), with round corners (R0.5 at the screen, R1.8 on the face). The screen you see,
the panel's fit and the print time are unchanged, and it still prints face down with no supports. On the chinless tub
the wordmark moves 0.35 mm down, to stay centred below the wider bevel. Only the tub changed: to get it, reprint just
the tub. The light-strip tubs (`tub-light-strip`, `tub-light-strip-chinless`) keep the old window for now.

**Bottom keys, both cases, 2026-10-12: a deeper well for each crank cheek** (Ian, from his printed and assembled
cases: "The crank hits a friction point when rotating from its button side to its switch side ... Perhaps the well
where this area sits can be made deeper?").
- **What it was.** Turned by hand in the open tub (face down, before the board is in), each crank's cheek rubbed the
  roof of its slot in the rail at about 40 degrees. The top corner of the cheek's loop passed under a roof that printed
  a little low. Face down, the crank and the rod sag through their play toward it.
- **The fix.** Each cheek slot's roof is higher: 0.45 mm on the 4.26 (z 3.60, was 3.15). On the 3.68 the slot now
  runs up to the skin (z 3.47; the 0.32 mm strip of rail over it is gone).
- **What to reprint.** Only the tub of a keyed case: on the 4.26 `4.26/tub-standard` or `4.26/tub-light-strip` (and
  every keyed configuration's tub), on the 3.68 `3.68/tub-standard` or `3.68/tub-light-strip`. The cranks, keys, rod,
  gate, lid and midplate are unchanged: keep the ones you have. The chinless tubs have no cranks and are unchanged.
- **In use** (board in, keys pressed) a 4.26 crank never reaches the rub: on the 4.26 the friction was only in
  assembly, turning a crank past about 20 degrees by hand, so a 4.26 case that works can stay as it is. The 3.68's
  in-use margin at the switch was thin too (down to about 0 at the worst stack-up), so reprint its tub.

**Your printed 4.26 case (test 2):** reprint **the tub you use (`tub-standard`; `tub-light-strip` is for the
unreleased light-strip case) and 4 `key-426`**. Both print with supports off, the keys on their -X end. The lid, midplate, cranks, gate and rod stay.

1. Open `silkscreen-426-plates.3mf` at plate 1 (standard tub).
2. Delete everything on it except the tub and the 4 keys.
3. Optional, first: `coupon-chin` with one `key-426` (plate 4, about 15 minutes) checks the hooks in their slots.
   It is a fit check only: nothing is chosen from it.
4. Assemble with the tub **face down, on a cloth, from the keys until the board is in**:
   - Drop each key in from inside, hooks in its two slots, and let it slide out until both hooks stop. It stands
     2.4 mm proud (2.5 before the 2026-10-03 keys) and level, and fits only one way round.
   - Then drop in the cranks (each rests on its key), and fit the rod, the gate, the board and the lid.
   - If the tub is turned face up before the board is in, the keys sink (or fall in, before the rod). Turn it face
     down again and they come back.
   - `4.26/ROD.txt` has the same steps.

In use, face up or held to read, each key rests on its switch as before. Face down, the keys drop 1.0 mm outward
onto their hooks, all level, and settle back when the case is turned over.

If your case is still the test-1 print, also reprint the 4 cranks (crank-M from plate 2 if your board has APEM
switches) and the lid. Ream the cranks' bores first.

Print from the plate file, not the loose STLs in `4.26/`. The plate file carries each part's own settings: Arachne
walls on the cranks, elephant-foot compensation 0 on the cranks, keys and gates, a 2-layer raft under every key and
crank (above), and the lid's side-key supports (see "Supports" below). A loose STL needs these set by hand.

Test 1 (2026-09-29, the 4.26 case): the cranks' open hooks cracked and some cranks came off the rod, the right-hand
(+X) side keys did not click, and the key's slit showed on the button face. Fixed since:

- **Cranks:** each cheek is a closed ring round the rod, printed with Arachne walls. Since 2026-09-30 the ring is
  thicker where it holds the rod: a round bore with 0.80 mm of wall over the rod (0.75 at the least, was 0.57).
- **Bottom keys:** printed on end, with no slit on the button face.
- **Side keys:** the +X nubs are 0.10 longer.

Every crank and key still prints with supports off, and so do the tubs with their new key slots. Why: the case
READMEs' "Bottom keys" and "Side keys" sections.

If your lid is still the test-1 lid, you can test the side-key fix on your case with no print:

1. Put 2 layers of clear office tape on the tip of each right-hand key's nub. That adds about 0.10 mm, the same as
   the new nubs.
2. Refit the lid and press the three right-hand keys: the two page keys and the power key (SW1, SW4, SW10).
3. If they click like the left side, the new lid will work. If they still don't click, don't reprint the lid yet.

**3.68:** not printed yet. Its files carry the same fixes, the hook keys included, and its cranks are the same part
as the 4.26's. Print it whole from `silkscreen-368-plates.3mf` (or, for the standard build on any printer, its own
OrcaSlicer project: "The 3.68: its own OrcaSlicer project too" below), and assemble it face down as above
(`3.68/ROD.txt`).

**3.68 screen bevel, 2026-10-10 (Ian: "go with +0.4 on the 3.68"; not printed yet):** the standard tub
(`tub-standard`) has the 4.26's wider, rounded bevel round the screen: one 35-degree slope from the face down to the
screen, 1.29 mm wide on the face (before: 0.3 mm at 45 degrees, then a 0.3 mm straight step at the screen's edge), with
round corners (R0.4 at the screen, R1.7 on the face). For that its front face is 0.4 mm higher (the skin over the
panel's border 1.0 mm, was 0.6), so the case is 11.7 mm deep (was 11.3; 13.2 at the bottom keys), and `key-x3std` is
0.4 mm taller, its hooks 0.4 mm higher and the slots they run in too. The screen you see and the panel's fit are
unchanged, and the tub still prints face down with no supports: about 29 min and 10.5 g (was 26.5 min and 9.3 g).
**Old and new parts don't mix:** print `tub-standard`, its 4 `key-x3std` and the coupons (`coupon-strip-x3std`,
`coupon-gate-x3std`) together, all from this version. The lid, midplate, cranks, gate and rod are unchanged, and so is
the whole light-strip build (`tub-light-strip`, `key-x3ls` and its coupons).

**3.68 lid that would not shut, 2026-10-12 (the first print, Ian):** the lid stopped about 1 mm short and rocked,
with or without the battery. The latch arms, bent by the tub's tongue on the way in, landed on the midplate's edge,
and the lid left only 0.1 mm of air over the pack for a Rev 1.0 board's charging wires. **Reprint `lid` and
`midplate`** (both builds share them): the midplate's latch notches are 1.6 mm deep (were 0.7), and the lid has 1.0
mm more air behind the board, a chamfer on every latch arm, and the same screw seats, posts and latches. The case is
12.7 mm deep (was 11.7; the light-strip build 13.5, was 12.5). The tubs, keys, cranks, gate and rod are unchanged.
To try it on the old parts first, cut the old midplate's notches 0.9 mm deeper and close the lid without the
battery (`../enclosures/case-368/README.md`, "The lid closing", which also has the board checklist).

**3.68 side keys that printed badly, 2026-10-12 (the second print, Ian: "it really messed up around the side
switches"):** sliced with this folder's plate file (the Elegoo CC2 presets), no side key of that lid had a first
layer. Each key's foot left only a 0.3 mm strip on the bed, too thin for the slicer to print, so every key started
0.2 mm above the bed, tied to nothing, and the rest of the key was built on that. **Reprint `lid`** (both builds
share it): each key's foot now reaches 0.2 mm further in at the bed, as on the 4.26, so the key prints a first layer
along its whole length, and its hinge is 0.4 mm longer, so the keys press as before. Nothing else changed: keep the
new midplate and everything else. The website's generic-presets project printed a thin first layer there, so its
lids were not affected. Checked in the OrcaSlicer CLI, not printed yet (`../enclosures/case-368/README.md`, "The side
keys' first layer").

**3.68 screws that never bite and a lid that won't stay shut, 2026-10-13 (Ian: the bottom screws "never bite", the
corner above the power key won't stay closed; his decisions the same day):** read from the G-code of the lid he
printed and of this folder's plate file. The bottom pair went through the board into only 2.0 mm of plastic; the four
backstops and the rib along the lid's top edge printed 0.065 mm taller than drawn and met the midplate before the rims
met; and the latches let the lid lift 0.2 mm before they held. **Reprint `lid`, your build's tub (`tub-standard` or
`tub-light-strip`) and `midplate`, together; use four M2 x 8 socket head cap screws (pan heads also fit).** The bottom
two screws move into the chin's corners (7.2 mm of thread, was 2.0), so on the back the two lower heads sit about 8 mm
lower and 1.75 mm further out; a fourth screw closes the corner above the power key (its counterbore leaves a small
notch, about 0.4 mm, in the back's rounded edge, as on the 4.26's top screw); the backstops and the rib print 0.2 mm
lower; the latch barbs sit one layer lower, so they hold from the first touch. The same lid also fixes the power key (SW7 on the x3 board),
which printed with a small hole in its nub (the corner toward the case's bottom, at the key: the nub stood free of the
key there across a 0.1-0.2 mm slit); its nub is now fused to the key. Nothing changes on the front. The keys, cranks,
gate and rod are unchanged; the gate's proof coupon now carries part of a corner block and need not be reprinted.
Checked in the OrcaSlicer CLI with the CC2 presets, not printed yet (`../enclosures/case-368/README.md`, "Four screws,
and the lid where it really sits" and "SW7's nub, fused to its key").

**A one-loop skirt, both cases, 2026-10-13 (Ian's decision):** both plate files and every configuration's OrcaSlicer
project now print one loop of skirt, 3 mm round the first layer, before anything else. The job used to start on a
side key's hinge support, straight after the purge line (the power key's, SW7, on the 3.68 lid Ian printed; a 4.26 lid printed
alone starts on the left lower page key's, SW5); now it starts on the skirt. Peel it off. No part changes, and nothing needs reprinting for
it: it comes with your next print. If you slice a loose STL, set *Skirt loops* 1, *Skirt height* 1 layer, *Skirt
distance* 3 mm. In ElegooSlicer the plate files' skirt is listed as a changed setting, so it should be kept;
check that the preview shows a line round the parts on the first layer.

**4.26 lid that closes only under the screws, 2026-10-12 (Ian: "sure, go for it"):** the same fault as the 3.68's.
On the way in the tub's tongue bends each latch arm 0.45 mm inward, and the bent arms' square tops landed on the
midplate's edge 0.48 mm before home (all 13), and on the board's back if it sat toward a wall. **Reprint the lid and
the midplate** (`4.26/lid`, or `4.26/lid-chinless` for a chinless case, and `4.26/midplate`; every configuration's
lid and midplate changed the same way): every latch arm's inner top corner is chamfered 0.4 x 0.4 mm, and the
midplate's latch notches are 0.85 mm deep (were 0.7; their last 0.1 mm stays 0.7 beside a click-in detent strip, so
the strips still print joined to the plate). The case is no thicker, the latches hold as before, and the
tubs, keys, cranks, gate and rod are unchanged. To try it on the old parts first: shave each latch arm's inner top
corner (the side facing into the case) about 0.4 x 0.4 mm with a knife, centre the board between the side walls, and
close the lid (`../enclosures/case-426/README.md`, "The lid closing").

**4.26 lid: socket head screws sit flush, 2026-10-13 (Ian's screws are socket head caps, ISO 4762):** the lid's three
counterbores were 1.8 mm deep, drawn for pan heads (1.6 tall), so a socket head (2.0 tall) stood 0.2 mm proud of the
back. They are now 2.0 mm deep: a socket head sits flush with the back, a pan head 0.4 mm below it. **Reprint the
4.26 lid only** (`4.26/lid`, or `4.26/lid-chinless` for a chinless case; every configuration's lid changed the same
way) **for flush heads; with pan heads the reprint is optional.** The same M2 x 10 screws go 0.2 mm further in (3.6 mm
of thread at the bottom pair, the tips 0.8 mm short of the front face). The tubs, midplate, keys, cranks, gate and rod
are unchanged, and the lid prints as before, with no supports at the screw holes. The 3.68's counterbores (3.6 and
2.6 mm deep) already take socket heads. Checked in the OrcaSlicer CLI with the CC2 presets, not printed yet
(`../enclosures/case-426/README.md`, "Socket head screws").

**3.68 lid, 2026-10-19 (Ian: the lid bulged at the top middle and would not go fully down; the study found the bay too
tight for a real cell, no safe place for its lead, and side keys that stood on one bead):** **reprint `lid` only** (the
standard and light-strip builds share it; the tub, midplate, keys, cranks, gate and rod are unchanged). The back is one
layer thicker and the bay one layer deeper, so the case is **12.9 mm** deep (light strip 13.7; was 12.7 and 13.5): a
503035 up to 5.3 mm thick with two layers of tape on each face (6.02 mm) now has 0.445 mm of air under the microSD socket (J7). The two hooks
are gone; the lip is raised so the cell tucks under it, pushed right and down until it stops under the lip, held with tape. The lead lies on
the midplate's bare back above the battery connector (J5), held by one strip of tape, with any spare coiled flat beside it (the README's
*The battery* has the route). The backstop posts moved 3.45 mm past the board's cut, and the top rib is a low fence.
The same lid has six internal ribs and latch arms that are 1.3 thick at the root (nothing shows outside; the lid
snaps on with about 5.5 N an arm, was 3.3, and the long edges let go at roughly 19-22 N, was 12-16 N), and its side
keys stand on a teardrop base (below). The lid prints in about 40 min and 13.6 g on the CC2 (was 36 min, 11.4 g). The
counterbores are 0.2 deeper, so the same four M2 x 8 screws bite as before. Checked
in the OrcaSlicer CLI and in CAD, not printed yet (`../enclosures/case-368/README.md`, "The battery bay (2026-10-19)").

**2026-10-20: the keys' bottom edge is rounded again (teardrop).** Ian chose 'teardrop': the round is kept down to its
45-degree point, then a 45 to the bed, so a key stands on 0.83 mm of bed with its second layer 76 % on it (both presets;
the round's was 0.52 mm and 43 %, the square's 1.70 and 94 %). **Reprint both lids: the 3.68 lid (`3.68/lid`, in
`silkscreen-368-plates.3mf`) and the 4.26 lid (`4.26/lid`, or `4.26/lid-chinless`).** Nothing else changed. Sliced in the
OrcaSlicer CLI for both sizes on both profiles (the read-back passes on every key); not printed.

**Side keys, 2026-10-19 (Ian's photos: scraggly keys, both sizes):** as sliced, each side key stood from its hinge to
its free end on one 0.52 mm bead, its second layer 43 % on it. That day the corner of the back's round under each key was
filled square (1.70 mm of bed, second layer 94 %; the CC2 presets; the generic project 1.9 mm and 99.9 %); the
2026-10-20 teardrop above replaced the square edge. The 3.68's is the lid above. **The 4.26 has it too, and its files
here (`4.26/lid*`, `silkscreen-426-plates.3mf`) are regenerated.** Reprint the lid only (`4.26/lid`, or
`4.26/lid-chinless` for a chinless case; every configuration's lid changes the same way). All 32 configurations were
sliced on both the CC2 and the generic profiles and the read-back passes on every key (teardrop: CC2 and generic
0.83 mm of bed, 76 % second layer). The teardrop presses about the same as the round (at most 0.01 N firmer). Sliced
in the OrcaSlicer CLI for both sizes; nothing is printed (`../enclosures/case-368/README.md`,
"The side keys' base"). If a key still prints scraggly, photograph its bottom edge from the hinge notch to the free end
(turn the lid over).

**3.68 long sides, 2026-10-21 (Ian: with all four screws in, each long side is closed at the screws and bows open in the
middle; he chose the invisible change first): reprint the 3.68 tub only** (`3.68/tub-standard`, or `3.68/tub-light-strip`
for a light-strip case; the lid, midplate, keys, cranks, gate and rod are unchanged, and nothing shows from outside). The
board was clamped line to line between the lid's two posts and the tub's two bosses at the board's two bottom mounting holes (H3/H4), 8.25 mm above the bottom
corner screws with no screw through it, so any extra board thickness levered the lid open along its long sides. The tub's
two bosses are now two layers (0.4 mm) shorter: the board floats there, with 0.40 mm of room to the bosses as printed
and 0.24 mm with a board 0.16 mm thicker (the check fails under 0.20 and fails on the old tub, 0.000). That is the room
to the bosses only: the midplate's back is 0.13 mm in front of the board at its bottom edge (0.03 mm with a thick
panel), so a board more than about 0.13 mm thicker than 1.6 still meets the midplate first and props the lid, until the
parked +0.4 mm spring room is built. The board still sits on the lid's
posts under the springs, and their pins still hold it. In the plate file `silkscreen-368-plates.3mf` the two tubs and
the two gate coupons changed (the coupons carry a 0.02 mm3 sliver of a boss; no need to reprint them). It is not proven
that this is what bows the sides (`../enclosures/case-368/README.md`, "The long sides"). Sliced in the OrcaSlicer CLI with the CC2 and generic presets
(nothing new over air, the tub 0.02 g lighter); not printed.

**USB-C port, 2026-10-22 (the port fits board Rev 1.0 and Rev 1.02): reprint the tub of either size, and for the 3.68 the
lid too.** Board Rev 1.02 puts a surface-mount USB-C socket where Rev 1.0 has a through-hole one, and its opening sits
0.14 mm nearer the board. As printed, a plug in it touched the port hole's board-side edge in both sizes (in the 3.68 a
Rev 1.0 plug was also close to the lid's port block on the other side). The hole now reaches one layer further toward the board
(the edge moves one layer, 0.2 mm as printed, onto a layer line in both tubs), the divot moves with it (it is 0.16 mm taller in
the 4.26, 0.23 mm in the 3.68, on the board side only), and in the 3.68 the lid's port block is one layer lower (0.2 mm as printed; 0.1 drawn).
**Reprint the tub you use (4.26: `4.26/tub-*` for your configuration, every configuration's tub changes the same way; 3.68:
`3.68/tub-standard` or `3.68/tub-light-strip`), and for the 3.68 also `3.68/lid`.** The 4.26 lid, the midplates, keys, cranks,
gate and rod are unchanged, and in the plate files only those objects changed. The new tub fits a Rev 1.0 board too: a
plug in either board's socket clears the hole by at least 0.13 mm on every flat as printed (the old tub: 0.07 on Rev 1.0
and −0.07, touching, on Rev 1.02, once the socket's real seat height is counted). `slice_check` now reads this back and
fails under 0.10 (`../enclosures/case-368/README.md`, "The USB port fits board Rev 1.0 and Rev 1.02", and the 4.26's section
5.9). Sliced in the OrcaSlicer CLI with the CC2 and generic presets; not printed. The case does not back the
1.2 mm of J1 that overhangs the board's edge (on either board); a tab on the board under J1 would be the clean fix if a
sample needs it.

**Both cases, 2026-10-23 (Emily B (mixmastermouse)'s edit; reprint the tub, the lid and the midplate):** Emily B (mixmastermouse) edited
the 4.26 standard case in Onshape and Ian took six of the changes, made here in both cases where they apply.
- **Top screw (4.26, every configuration; the tub):** a 2.4 clearance bore from the rim to the board's front face, so the screw
  bites the last 3.8 mm of its pilot, 3.6 mm as printed (3.3 with the lid 0.3 open) like the two bottom screws, instead of 9.0
  (Emily B reports it stripped heads). The 3.68's screws are unchanged.
- **The wordmark is on the lid's back, above the grip grooves** (the lid), and the chin is plain (the tub). On the 4.26 it
  sits 2.6 mm above the top groove (the chinless case: above its grooves at 2 / 4 / 6); on the 3.68 the same distance. The
  book icon stays in the centre.
- **No V at the parting line** (tub and lid): both halves are square.
- **Side pads 1.2 mm proud** (the lid, which carries the side keys; was 1.5): 0.80 / 0.70 at the click.
- **Plain pins on the midplate** (was snap posts): the PCBA sits on three pins (4.26: H1, H2, H6; 3.68: H2, H6) that locate it
  to ±0.155 mm; **it no longer clicks onto the midplate before the lid goes on, so keep the stack face down until the lid is
  on.** With the lid on nothing else changes.
Reprint `tub-*`, `lid` (`lid-chinless`) and `midplate` for your size and configuration; the keys, cranks, gate and rod are
unchanged. Both plate files and every configuration's project carry the new parts, and nothing else in them moved. Sliced in
the OrcaSlicer CLI with the CC2 and generic presets and read back from the G-code; not printed. (`../enclosures/case-426/README.md`,
"Emily B's edit"; the 3.68's section of the same name.)

**4.26 lid and midplate, 2026-10-24 (the same reprint: the bulge fix):** the 4.26 lid (`lid`, `lid-chinless`) and midplate that you
reprint for the 2026-10-23 changes also carry this, so there is nothing more to print. The lid's board posts H2, H5 and H6 stand one
layer (0.2) shorter, so the board rests on H1 and the lid's middle bows about 40 % less (a model estimate, not measured on a print;
H5's pin still reaches 0.8 mm into the board and still locates its top end). The midplate loses one screen spring, at the J6 header,
that printed as loose islands and pushed on nothing. The 3.68 is unchanged by this. If you already printed the 2026-10-23 files, the
lid and the midplate are the only parts that change; the tub, keys, cranks, gate and rod do not. Sliced in the OrcaSlicer CLI with
the CC2 and generic presets and read back from the G-code; not printed. (`../enclosures/case-426/README.md`, "The lid's bulge and
the board's posts".)

**Two-colour logo, a switch in the one file (2026-10-24; replaces the separate `-2colour` files of 2026-10-23):** the lid's two
back engravings (the wordmark and the book icon) can be filled with a second colour. Every lid, in both plate files and in
every per-configuration project, now carries the two bodies that fill them as parts that do nothing until you switch them on,
so the whole case stays on one plate and the logo prints as an empty engraving in one colour by default (OFF is the same job as
before: same layers and filament, time within a few seconds). The `silkscreen-426-plates-2colour.3mf` and `silkscreen-368-plates-2colour.3mf`
files and the `-2colour` per-configuration projects (`index-2colour.json`) are gone. The logo is the lid's first two layers, so
a manual filament swap cannot make it: you need a printer that changes filament by itself (a multi-material system or a tool
changer). To switch it on, in OrcaSlicer:

1. On the **Prepare** tab, in the object list on the left, click the arrow beside the **lid** to expand it. Under it are the
   side-key support parts and two parts named `logo wordmark: ...` and `logo icon: ...`. Right-click the parts' rows in this
   list, not the model in the 3D view.
2. Click **one** logo part (no Ctrl), right-click its row -> **Change type** -> **Part**. Newer OrcaSlicer shows a submenu;
   ElegooSlicer and older OrcaSlicer open a small "Choose part type" dialog: pick Part, then OK. With two parts selected,
   some versions leave Change type out of the menu, so do one at a time.
3. Do the same for the other logo part.
4. Ctrl+click both logo parts, right-click -> **Set Filament for selected items** (it reads **Change Filament** when one part
   is selected) -> the second filament in the list, shown by its colour swatch (not "Default"). Or click each part's
   filament cell in the object list.
5. Set filament 2 to the logo's colour and filament 1 to the case's (the files preview them as a light colour and black).
6. Slice. Only the lid's first two layers use filament 2; the rest of the case, the lid's supports and the rafts stay filament 1.

The projects define both filaments and have **Prime tower off**, and a keyed plate cannot have one: OrcaSlicer refuses a prime
tower on a plate whose objects print over different numbers of raft layers ("The prime tower requires that all objects are
printed over the same number of raft layers"), and the keys and cranks sit on rafts. So the colour change uses your printer's
own purge: the Elegoo CC2 profile, an AMS-style system and a tool changer purge in the machine. Choose your printer's own
profile when you switch the logo on, because the generic Marlin profile in these files has no purge of its own. A printer that
can only purge into a prime tower (a Prusa MMU, for example) should first drag the lid onto an empty plate, then switch the
prime tower on (process settings, **Multimaterial** tab -> **Prime tower** -> **Enable**); every plate's tower position is already set to a free spot (`wipe_tower_x`, `wipe_tower_y`).
On the chinless plate, which has no rafts, you can switch the tower on without moving the lid. The bodies are also single
files: `4.26/lid-inlay-wordmark`, `lid-inlay-icon` (and `lid-chinless-inlay-*`), `3.68/lid-inlay-*`, in the lid's own print frame.

**The logos' thin strokes widened (2026-11-07; sliced in the OrcaSlicer CLI and read back from the G-code, not printed):** with the
logo switched on, the CC2's classic walls left the thinnest strokes bare (the icon's two diagonal page lines, the e's crossbar, the
thin tops of the s, c and e), because a body narrower than the first layer's line prints nothing. The wordmark is now 0.12 mm
heavier all round (every stroke 0.24 wider, the thinnest about 0.6), and the icon's strokes under 0.7 mm are widened toward 0.7
(its outline and the gaps between its lines unchanged); same sizes and places. With the logo on, every stroke now gets filament-2
lines on both printers. This changes every lid and every slide cover, their logo bodies, both plate files, the cover plate file and
every per-configuration project; tubs, midplates, keys and the rest are the same. For a case you already printed nothing is needed:
with one colour the engraving just looks a little bolder.

**Three front lines on every tub, engraved by default (2026-11-06, engraved as shipped since 2026-11-07; sliced in the OrcaSlicer CLI and read back from the G-code, nothing printed yet):**
the idea is @juno_last's case design. Every plate file and every per-configuration project carries the three lines on the tub's
front as one Negative Volume part, so as shipped they print as grooves in the case colour, with one filament. Every tub has them,
the 3.68 light-strip tub included. The lines are three straight horizontal lines with rounded ends,
1.0 mm wide on a 2.5 mm pitch and 48.0 mm long, centred on the case's centre line, 0.6 mm (three layers) deep from the front face.
With bottom keys they sit between the key openings and the screen window's bottom edge (5.7 mm clear of both on the 4.26, 5.0 on the
3.68); on a chinless tub between the window's bottom edge and the case's bottom edge (4.0 mm clear of both, the front round included).
Only the second-colour option needs a printer that changes filament by itself (the colour is on the tub's first three layers).
In OrcaSlicer, on the **Prepare** tab, click the arrow beside the **tub** in the object list: under it is one part named
`front lines: engraved (...)` that holds all three lines. Pick one:

1. **Engraved, in the case colour (the default):** do nothing. The first three layers have a line-shaped gap; the fourth bridges it.
2. **No lines:** click the part, right-click its row -> **Change type** -> **Modifier** (ElegooSlicer and older OrcaSlicer open a
   small "Choose part type" dialog: pick Modifier, then OK). A modifier with nothing set changes nothing: the tub prints solid, in
   filament 1. (Deleting the part does the same.)
3. **Flush, in a second colour:** make it a **Modifier** as in 2, then right-click it -> **Change Filament** -> the second
   filament, shown by its colour swatch. It recolours the tub's first three layers inside the line shapes, nothing else. Set
   filament 2's colour. The prime tower is off here, as for the logo (see above for a printer that can only purge into a tower).

The bodies are also single files in the tub's print frame: `4.26/tub-front-lines.stl` (the standard and light-strip tubs with bottom
keys), `4.26/tub-front-lines-chinless.stl` (both chinless tubs) and `3.68/tub-front-lines.stl` (both 3.68 tubs), made by `enclosures/color_options.py
write`. Pictures: `docs/images/color-front-lines.png` and `docs/images/color-front-lines-chinless.png`.

**Slide-on cover, 2026-11-01 (round 2 and 3; coupon A and Ian's phase-2 cover were printed, the phase-3 cover described here was not):** a TI-84 style reversible cover, one printed part, that goes over
the screen to carry the reader and over the back while you read it. It slides on sideways (along the case's width), gripping the top and
bottom end walls; a snap at its open end clicks it home in the case's rounded corners, and two corner pieces set the other end. It goes on any of
four ways (front or back, either way round), its long sides curve inward over the side keys, its edges are rounded, and the Silkscreen icon and
wordmark and a rounded-rectangle border (two lines) are engraved on its outer face (the logo reads upside down in the two turned poses), the plate is solid over the screen, and the snap tab ends in a rounded tongue. **The case does not change**, so it fits every case
already printed. Three covers, by envelope: `cover/4.26/cover-keyed` (the 16 4.26 builds with bottom keys, light strip included),
`cover/4.26/cover-chinless` (the 16 chinless builds), `cover/3.68/cover-standard`. They have their own, **temporary**, plate file,
`silkscreen-cover-plates.3mf` (one plate per cover; the coupons are gone) and, since 2026-11-01, **in the case plate files and in every per-configuration project too** (below).
Each carries its two logo bodies as modifier parts with no filament, named like the lid's: the two-colour logo is a switch, OFF (see "Two-colour logo").
Each is 21 to 23 g and about 1 h 10 to 1 h 17 (the CC2 presets: about 36 to 40 minutes; see the cover README) with no supports.

**Where the cover is (2026-11-01).** Every per-configuration project, generic and CC2, carries its cover as an object on a plate with room for it, placed by the plate's own spacing rules (nothing else on any plate moved). 4.26 projects with bottom keys: on **plate 2, "Only for APEM MJTP1117 boards: crank-M"** (the cover sits beside the four crank-M; a builder without an APEM board prints that plate for the cover and leaves the cranks off). 4.26 chinless projects (no APEM plate): a **new plate 2, "Slide cover (chinless)"**. 3.68 project: generic, on the APEM plate (plate 2); CC2, on the lid's plate (plate 1). The public `silkscreen-426-plates.3mf`: the keyed cover on plate 2 (APEM), the chinless cover on a new plate 5; `silkscreen-368-plates.3mf`: on plate 2 (APEM). Ian's CC2 files (`cc2-local/`): the 4.26 file has new plates 6 and 7 for the covers (the keyed cover for the standard and the light-strip case and the chinless cover on plate 6, the light-strip chinless cover on plate 7); the 3.68 file has it on the lid's plate. Each cover carries its two logo bodies as modifier parts with no filament, like the lid (the two-colour switch is OFF); no cover has supports. `silkscreen-cover-plates.3mf` stays as the cover-only file. See [`../enclosures/cover/README.md`](../enclosures/cover/README.md) for how
to put it on in the four poses, the fit numbers and what is estimated, not measured. The files are in `cover/`, not in `4.26/` or `3.68/`:
both case builds delete any file in their size folder that they did not make.

## Start here: the plate file

Open the plate file for your reader in OrcaSlicer:

- [`silkscreen-426-plates.3mf`](silkscreen-426-plates.3mf): the 4.26in case
- [`silkscreen-368-plates.3mf`](silkscreen-368-plates.3mf): the 3.68in (x3) case

Each is a generic OrcaSlicer project, the same setup as the per-configuration projects the website serves: Generic
Marlin Printer (0.4 nozzle), 0.20mm Standard, Generic PLA, Textured PEI, no brim, a one-loop skirt, every plate laid out
for a 220 x 210 mm bed. It should open in OrcaSlicer 2.3.2 and later (checked in the 2.4.0-dev GUI; 2.4.2 loads it the same way by its source); pick your own
printer and filament; keep the project's changed settings if OrcaSlicer asks. Files from before 2026-10-21 crash
OrcaSlicer 2.3.2 and later on opening (they had no `filament_colour`); if yours does, take the current file.
The keys, cranks and gates already carry elephant-foot compensation 0, and the cranks Arachne walls. Every key and
crank already sits on a 2-layer raft ("Rafts" below). The lid already carries its side-key supports (below) and a two-colour
logo that is switched off (above). The files
hold the released builds only: the standard build, and on the 4.26 the chinless one. The 3.68 file has three plates, the
4.26 file four:

| Plate | What is on it |
|---|---|
| 1 "Case: touch panel, bottom keys, ..." (3.68: "Case: standard: bare x3 panel, ...") | the standard tub, lid, midplate, 4 bottom keys, 4 crank-T, 2 gates (one is a spare) and the rod jig |
| 2 "Only for APEM MJTP1117 boards: crank-M" | 4 crank-M |
| 3 "Case: touch panel, chinless, ...", 4.26 only | the chinless tub and lid and the midplate, nothing else; only for a board without the bottom-row buttons (SW9/SW8/SW3/SW2) fitted (above) |
| 3 (3.68) / 4 (4.26) "Test prints" | the PCBA test-fit dummy, the chin coupon (3.68: coupon-strip) with a key to try in it (the hook keys' optional fit check), the gate coupon with a gate |

The light-strip builds are in development (rev A, untested), are not released and are not in these files. The author's
own CC2 plate files, which have them, are made with `make_plates.py --printer cc2` into `print/cc2-local/` (not in git;
Elegoo Centauri Carbon 2 presets, a 256 mm layout, five plates on the 4.26: standard, light-strip, test prints and
extras, chinless, light-strip chinless).

1. **Print the gate coupon first** (the last plate), once per printer and filament: it checks the gate's fit. The chin
   coupon on the same plate (4.26: `coupon-chin` with a `key-426`; 3.68: `coupon-strip` with its build's key) is an
   optional fit check for the hook keys; nothing is chosen from it. The case README's "Bottom keys" section says what
   to look for.
2. **Print plate 1** (4.26: the GDEQ0426T82-FT01C touch and frontlight panel; 3.68: the bare x3 panel). On the 4.26
   with a board without the bottom switches, print plate 3 (chinless, touch panel) instead; it needs none of steps 1,
   3 and 4.
3. **Pick the cranks for your board's switches:** crank-T (plate 1) for SHOU HAN TS365ZJ switches, which every
   JLC-assembled board has; crank-M (plate 2) for APEM MJTP1117 switches.
4. **Make the rod** (not printed): 63.25 mm of 1.75 mm PLA filament, straightened and cut in the rod jig. The steps
   are in `4.26/ROD.txt` and `3.68/ROD.txt`.

Also needed: M2 socket head cap screws (ISO 4762; pan heads, ISO 7045, also fit) for the lid: three M2 x 10 on the
4.26, four M2 x 8 on the 3.68 (three before 2026-10-13; never M2 x 10, which would come out of its face). The heads
sit flush with the back or below it (the 4.26's since 2026-10-13: an older 4.26 lid leaves a socket head 0.2 mm
proud).

### 4.26: the battery

The 4.26 case takes a 503035 LiPo (500 mAh; the case's model is 37.2 x 31.1 x 5.18 mm with its wrap and protection
board), held in the midplate's slot under its lip and snaps; a pack much thicker than 5.2 mm won't go under them.
Most sellers have it: Amazon US (AKZYTUE, Liter, Winfox, CKWJMUBS, LJHLR, ...), Adafruit #1578, Pimoroni.

- **Connector:** JST PH 2.0, 2 pins. Its polarity is **not standardised**: sellers wire it both ways, and one brand
  can ship both. Before the first plug-in, check with a meter that the red wire goes to the + pin of the battery connector
  (J5; the + is marked on the board's silkscreen). A PHR-2 housing can be re-pinned by lifting its two latches with a pin.
- **Protection board:** buy only a listing that states one (PCM, protection circuit). Some 503035 listings come with
  PH 1.25 or 3-pin leads by default; pick the 2-pin PH 2.0 option.
- **Charge voltage:** the board's charger stops at 4.2 V, so a "high-voltage" (4.35 V) cell is safe; it is only
  slightly undercharged.
- **Lead:** wind any spare lead round the midplate's two cleats.

### Supports

Only the lid gets supports, and only under its side keys (since 2026-09-30). Leave supports off for everything
else, and don't switch on automatic supports: the slicer would put them on the keys, cranks and gate, which don't
need them. The rafts under the keys and cranks are not supports: they are set per object, with supports still off.

- **Where:** each side key's hinge notch. For 3 mm from the key's root (where it joins the lid), the key's foot is
  cut away up to 1.05 mm above the bed, so the bar over it prints over air (3.4 mm on the 3.68 since 2026-10-12).
  Each notch gets a small grid, 4 layers tall, with one 0.2 mm layer of air under the key. The slicer runs each grid
  1-1.5 mm past the key's root, under the lid's rounded back edge beside the hinge (a pinhead mark there at most). Nothing goes under the lid's logo, its grip
  grooves or its screw holes, and nothing on the tub.
- **In the plate file** this is already set: the lid has supports on in manual mode (supports only inside a support
  enforcer) and one enforcer box per side key (5 on the 4.26, 3 on the 3.68; the 4.26 chinless lid on plate 3 (plates 4 and 5 of the CC2 file)
  has the same 5, and a 4.26 side-key layout's lid one per key it has, 3). Every other object has supports off.
- **After printing,** pick each grid out of its notch from outside the case with a fingernail or tweezers. It sits
  one 0.2 mm air layer under the bar, with no dense interface, and about 0.4 mm off the walls beside it. Checked with the
  OrcaSlicer CLI only: not printed yet, and not opened in ElegooSlicer.
- **From the STL instead:** in OrcaSlicer, on the lid only, set *Support* on, type *normal(manual)*, *on build plate
  only*, top Z distance 0.2, top interface layers 0, support/object XY distance 0.4, and the raft's initial layer
  expansion 0 (it also widens the support's first layer, into the slot behind the key). Then paint supports (or add
  a support enforcer) on the underside of each notch's roof only.

The screw holes need no supports: each head's counterbore steps to a slot and then a square over its ceiling, so
the two layers above the seat print as short bridges (since 2026-09-30).

### Rafts (bottom keys and cranks)

Every bottom key and every crank prints on a 2-layer raft (since 2026-10-06), so the small parts stay stuck to the
plate. The plate files set it per object; on a loose STL, in OrcaSlicer (or ElegooSlicer) right-click the object,
*Add settings* → *Support*, and set:

| Setting (OrcaSlicer) | Saved as | Value | Why |
|---|---|---|---|
| Raft layers | `raft_layers` | 2 | a 0.2 base layer and a 0.3 interface layer, its top 0.5 above the plate |
| Raft contact Z distance | `raft_contact_distance` | 0.2 | one 0.2 layer of air between the raft and the part, as under the lid's supports: it lifts off cleanly (Orca's default 0.1 bonds harder) |
| Raft expansion | `raft_expansion` | 1.5 (Orca's default, left as is) | the raft 1.5 mm wider all round than the part's end |
| Initial layer expansion (raft) | `raft_first_layer_expansion` | 1 | the raft's first layer 2.5 mm past the part's end; Orca's default 2 runs neighbouring rafts into each other at the plates' 6 mm spacing |

Keep elephant-foot compensation 0 (and Arachne walls on the cranks) as well. After printing, peel the raft off; a
light scrape of the key's -X end or the crank's pad end is fine, but don't sand the key's end: its length (10.00 mm,
50 layers) is its side play. Checked with the OrcaSlicer CLI on the plate files (each part reads as without the
raft, `slice_check.py`); not yet printed from these files, and not opened in ElegooSlicer.

## Any other 4.26 configuration: its own OrcaSlicer project

Each of the 32 configurations has an OrcaSlicer project of its own, `<slug>.3mf`, with what that case prints and
nothing else. **OrcaSlicer, any printer** (2026-10-11): these are the files the website is meant to serve, and they carry
OrcaSlicer's generic presets (Generic Marlin Printer 0.4 nozzle, 0.20mm Standard, Generic PLA), which every OrcaSlicer
install has, so they are not tied to one printer. Every plate fits a 220 x 210 mm bed (Ender-3 class 220 x 220,
Prusa MK4 250 x 210, Bambu 256 and anything larger).

- **Open it in OrcaSlicer, then pick your printer** in the printer box (and its 0.20 mm process and your PLA if Orca
  doesn't pick them). Keep a **0.4 mm nozzle and 0.2 mm layers** (first layer 0.2 too): the keys are exactly 50
  layers long, and the raft's air gap and the lid supports' gap are one layer.
- What the parts need rides on the parts, so a printer or process change keeps it: the rafts under the keys and
  cranks, the lid's side-key supports (supports only there), elephant-foot compensation 0 on the keys, cranks and
  gates, Arachne walls on the cranks, and no brim. Don't switch on automatic supports. The project also prints a
  one-loop skirt first (since 2026-10-13, a project setting, not a part's): if Orca asks on a printer change whether
  to keep the project's changed settings, keep them.
- **Other slicers are not supported.** PrusaSlicer, Cura and the rest don't read these per-part settings; use
  OrcaSlicer.

The two plate files above (`print/silkscreen-426-plates.3mf` and `silkscreen-368-plates.3mf`) are in git and
generic, like the per-configuration projects. The author's Elegoo Centauri Carbon 2 versions of both
(`make_plates.py --printer cc2`, into `print/cc2-local/`) and of the per-configuration files (`make_plates.py configs
--printer cc2`, into `out/configs-cc2/`) are his own working copies: git-ignored, not published, and made by running
those two commands. The generic per-configuration files are not in git either: the website is meant to publish them
(as of 2026-10-21 it does not yet); you can also make yours with the case project (below). The website's builder is to offer the 16 standard and chinless ones (side keys as one four-way choice,
as below); the light-strip ones are in development and it will not offer them. The top-level
[README](../README.md#print-a-case) lists what each file contains.

**1. Pick your slug,** `base[-sides][-nodev]`:
- **base**, by your panel and your board's bottom row:

  | | bottom-row buttons fitted (SW9, SW8, SW3, SW2) | bottom-row buttons NOT fitted |
  |---|---|---|
  | GDEQ0426T82-FT01C (touch + frontlight) | `standard` | `chinless` |
  | plain GDEY0426T82 + the Silkscreen light strip (in development, not released) | `light-strip` | `light-strip-chinless` |

- **sides**, the page keys you want, as you hold it (screen toward you): none for all four; `-leftkeys` for the left
  pair only (up and down on the left edge: SW7, SW5); `-rightkeys` for the right pair only (up and down on the right
  edge: SW4, SW1); `-upperkeys` for the upper key on each side (SW7, SW4). The power button (SW10, top of the right
  edge) is on every case. A key left out is the plain
  wall; its switch may stay on the board (the case clears it and never presses it).
- **`-nodev`** if your board has no dev header (the 12-pin expansion header, labelled J6). A board WITH the header
  needs a case without `-nodev`.
- Examples: `standard`, `chinless-upperkeys`, `chinless-leftkeys-nodev`. The 32 are listed with what each
  needs on the board in [`../enclosures/case-426/README.md`](../enclosures/case-426/README.md#the-32-configurations).

**2. Make it.** From `enclosures/case-426`, with the case project's Python (`$py`,
as in [`../enclosures/README.md`](../enclosures/README.md#rebuilding)):

```powershell
& $py -B src/pipeline.py --builds <slug>      # builds and checks it (and the twins its checks compare with)
```

The file is `enclosures/case-426/out/configs/<slug>.3mf` (the generic one), sliced and read back by the pipeline. A
run of all 32 (`src/pipeline.py`, about 1 h from nothing) writes every one.

**3. What is in it:** plate 1 "Case: <your configuration in words>": the tub and the lid (with one support enforcer
per side key it has) side by side, the midplate turned crosswise in front of them; with bottom keys also 4
`key-426`, 4 `crank-T` and 2 gates (one spare) beside the midplate and the rod jig beside the lid. With bottom keys,
plate 2 holds 4 `crank-M`, only for APEM MJTP1117 boards. There are no test prints: with bottom keys, print the gate
coupon from plate 4 of `silkscreen-426-plates.3mf` first (the plate file's step 1). About 41 g with bottom keys and
33 g chinless; the time is your printer profile's (the generic profile's cautious speeds give 3 h 20 min and 2 h 30
min, the CC2 1 h 40 min and 1 h 15 min). Checked with the OrcaSlicer CLI only (all 32 slice, a raft under every key
and crank, supports only in the lid's side-key enforcers): opened in the OrcaSlicer 2.4.0-dev GUI (2026-10-21) but not printed.

## The 3.68: its own OrcaSlicer project too (standard only)

The 3.68 has one released configuration, the standard build (the bare x3 panel); the light-strip 3.68 is not
released and has no project. Besides the plate file `silkscreen-368-plates.3mf` (above), it has an OrcaSlicer
project of its own like the 4.26's, `enclosures/case-368/out/configs/standard.3mf` (1.08 MB): the file the website is
meant to serve for the 3.68. It carries the same OrcaSlicer generic presets and fits the same 220 x 210 mm bed, and the same
rules apply: open it in OrcaSlicer, pick your printer, keep a 0.4 mm nozzle and 0.2 mm layers, other slicers are not
supported. Plate 1 "Case: standard: bare x3 panel, bottom keys, three side keys": the tub and the lid (one support
enforcer per side key, 3) side by side, the midplate turned crosswise in front of them, 4 `key-x3std`, 4 `crank-T` and
2 gates (one spare) beside the midplate and the rod jig beside the lid. Plate 2: 4 `crank-M`, only for APEM MJTP1117
boards. No test prints: print the gate coupon (`coupon-gate-x3std`) from plate 3 of the plate file first. Plate 1 is
35.50 g; the time is your printer profile's (3 h 14 min at the generic profile's cautious speeds); plate 2 is 0.84 g and
7 min.
Since 2026-10-13: four M2 x 8 socket head cap screws (pan heads also fit), and a one-loop skirt. Make it with the case
project: `make_plates.py configs --size 368` from `enclosures/`, once the standard build's `plates.py` has run
(`../enclosures/case-368/README.md`, "Print files"). Checked with the OrcaSlicer CLI only (both plates slice, a raft
under every key and crank, supports only in the lid's 3 enforcers, each key 50 layers): opened in the OrcaSlicer
2.4.0-dev GUI (2026-10-21), not printed.

## What is in this folder

| Path | What |
|---|---|
| `silkscreen-426-plates.3mf`, `silkscreen-368-plates.3mf` | the plate files above |
| `silkscreen-cover-plates.3mf`, [`cover/`](cover/) | the slide-on cover's temporary plate file (one plate per cover) and its parts, `cover/4.26/` and `cover/3.68/` (`.stl` as printed, `.step` in the case's CAD frame, `-inlay-*.stl` the logo bodies): 2026-11-01 round 2, no whole cover printed |
| `rod-jig.stl`, `rod-jig.step` | the rod jig, the same for both sizes (also on plate 1 of the plate files) |
| [`4.26/`](4.26/) | every 4.26 part on its own, and `ROD.txt` |
| [`3.68/`](3.68/) | every 3.68 part on its own, and `ROD.txt` |

In the size folders each part comes twice: `<part>.stl`, oriented and placed as it prints, and `<part>.step`, in the
case's CAD frame (the board's coordinates) for editing. The gate's STEP is in its print pose, like its STL.

- **Two-colour logo (optional):** `lid-inlay-wordmark`, `lid-inlay-icon` on both sizes, and `lid-chinless-inlay-wordmark`, `lid-chinless-inlay-icon` on the 4.26: the
  bodies that fill the lid's back engravings, in the lid's print frame. The plate files and projects already carry them in the
  lid, switched off ("Two-colour logo" above); the loose files are for other slicers or for editing.
- **Front lines (optional):** `4.26/tub-front-lines`, `4.26/tub-front-lines-chinless`, `3.68/tub-front-lines`: the three shells of the lines (one part) on the tub's front, in its print frame ("Three front lines"). The plate files and projects already carry them, as a Negative Volume (engraved).
- **Tubs:** `tub-standard`. `tub-light-strip` is for the light-strip case, which is in development and not released.
- **4.26 chinless:** `tub-chinless` and `lid-chinless`, its own tub and lid, with the shared `midplate`. The board
  must not have the bottom-row buttons (SW9/SW8/SW3/SW2) fitted.
- **4.26 light-strip chinless** (in development, not released): `tub-light-strip-chinless`, with `lid-chinless` and the
  shared `midplate`. The same board rule.
- **Shared by both builds** (standard and light-strip): `lid` (with the side keys), `midplate`, `crank-T`, `crank-M`,
  `gate`. On the 4.26 the bottom key (`key-426`) and the coupons are shared too, and the chinless case uses the same
  `midplate` (and the same side keys, in its own lid).
- **3.68 per build:** its keys (`key-x3std`, `key-x3ls`: the hook keys since test 2) and coupons (`coupon-strip-`
  and `coupon-gate-`, each `-x3std` or `-x3ls`) follow the tub. The coupon strip is the hook keys' optional fit check
  (its two slots, printed with one key); the drag coupon's keys are gone.
- **4.26 coupons:** `coupon-chin` (the hook keys' optional fit check: the chin around the Left key's (SW3's) opening with its
  two slots, printed with one `key-426`; the drag coupon's keys are gone) and `coupon-gate`.

## How these files are made

| Files | Written by |
|---|---|
| `4.26/`, `3.68/` | `enclosures/case-426/src/build.py` and `enclosures/case-368/src/build.py`, at the end of a full build (every print build: on the 4.26 standard, light-strip, chinless and light-strip chinless) |
| the two plate files | `enclosures/make_plates.py`, from each build's print-oriented STLs (`src/plates.py`, in `out/<build>/print/`, the logo bodies included): generic projects, the released builds only. `make_plates.py --printer cc2` writes the author's CC2 versions with every build to `cc2-local/` (git-ignored) |
| one OrcaSlicer project per 4.26 configuration (not in this folder) | `enclosures/make_plates.py configs`, into `enclosures/case-426/out/configs/` (OrcaSlicer's generic presets, what the website serves; `--printer cc2`: `out/configs-cc2/`; build output, not in git; above) |
| the 3.68 standard build's OrcaSlicer project (not in this folder) | `enclosures/make_plates.py configs --size 368`, into `enclosures/case-368/out/configs/standard.3mf` (the same generic presets, what the website serves; `--printer cc2`: `out/configs-cc2/`; build output, not in git; above) |
| `rod-jig.*` | `enclosures/rod_jig.py` |
| `silkscreen-cover-plates.3mf`, `cover/` | `enclosures/cover/` (`build_cover.py`, then `make_cover_plates.py`; `--printer cc2` writes `cc2-local/silkscreen-cover-plates.3mf`) |

The run order and the Python to use are in [`../enclosures/README.md`](../enclosures/README.md). A build removes any
file in its size folder that it no longer makes, so put nothing else there.
