iandchasse/silkscreen-enclosures/enclosures/case-368/hardware/board-2026-09-21/silkscreen_pcb.kicad_pcb

## KiCad design enclosures/case-368/hardware/board-2026-09-21/silkscreen_pcb.kicad_pcb (2026-10-21)

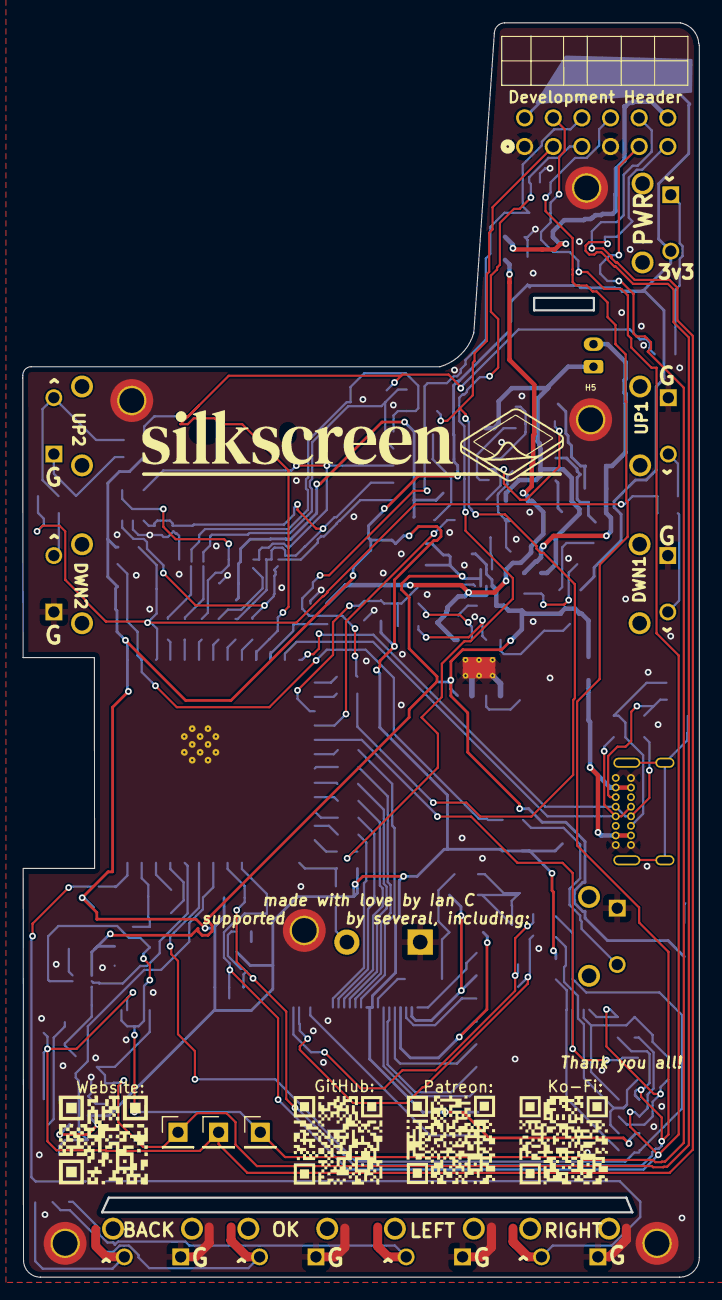
[picture p58: board silkscreen_pcb.kicad_pcb from above]

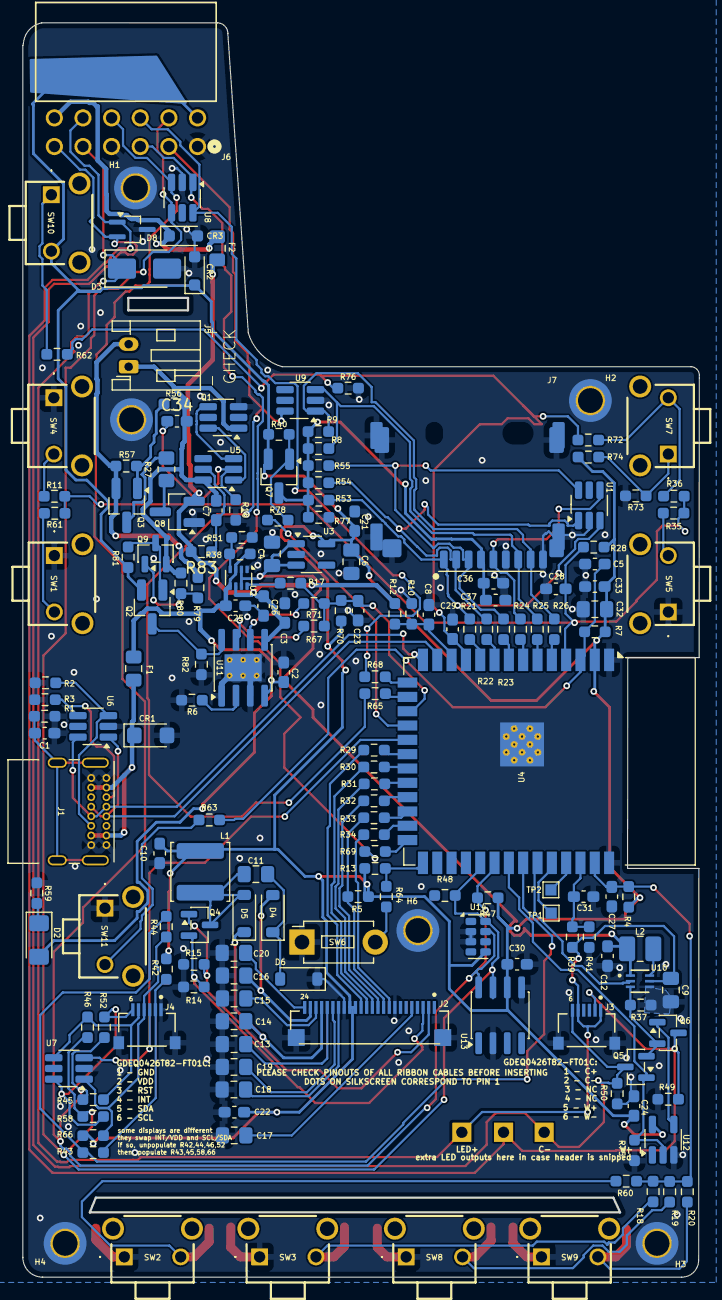
[picture p59: board silkscreen_pcb.kicad_pcb from below]

Board: 2 copper layers, 60.0 x 111.3 mm, 184 parts (180 on the bottom side), 113 nets.

Parts:
C1: 1n; C_0603_1608Metric_Pad1.08x0.95mm_HandSolder
C2: 10u/25V; C_0603_1608Metric_Pad1.08x0.95mm_HandSolder
C3: 10u; C_0603_1608Metric_Pad1.08x0.95mm_HandSolder
C4, C6, C32: 22u; C_0805_2012Metric_Pad1.18x1.45mm_HandSolder
C5, C8, C21, C22, C25, C26, C37: 1u; C_0603_1608Metric_Pad1.08x0.95mm_HandSolder
C7, C23, C24, C30, C31, C33, C36: 0.1u; C_0603_1608Metric_Pad1.08x0.95mm_HandSolder
C9, C11, C13, C14, C15, C16, C17: 4.7u/50V; C_0805_2012Metric_Pad1.18x1.45mm_HandSolder
C10, C12: 4.7u; C_0603_1608Metric_Pad1.08x0.95mm_HandSolder
C18, C19, C20: 1u/50V; C_0805_2012Metric_Pad1.18x1.45mm_HandSolder
C27, C28, C29, C34: 2.2n; C_0603_1608Metric_Pad1.08x0.95mm_HandSolder
CR1: SMF6.5CA; D_SMF
CR2, CR3: TSD05CDYFR; D_SOD-323_HandSoldering
D2: LED; LED_1206_3216Metric_Pad1.42x1.75mm_HandSolder
D3: SMAJ26A; D_SMA
D4, D5, D6: B5819W; D_SOD-123
D8: PESD2IVN-UX; SOT-323_SC-70_Handsoldering
F1: 0805L100WR; Fuse_0805_2012Metric_Pad1.15x1.40mm_HandSolder
F2: 0805L075WR; Fuse_0805_2012Metric_Pad1.15x1.40mm_HandSolder
H1, H2, H3, H4, H5, H6: MountingHole_Pad; MountingHole_2.2mm_M2_DIN965_Pad_TopBottom
J1: USB_C_Receptacle; USB_C_Receptacle_GCT_USB4085
J2: FH34SRJ-24S-0.5SH_50_; HRS_FH34SRJ-24S-0.5SH_50_
J3, J4: FH34SRJ-6S-0.5SH_50_; HRS_FH34SRJ-6S-0.5SH_50_
J5: Conn_01x02; JST_PH_S2B-PH-K_1x02_P2.00mm_Horizontal
J6: PPPC062LJBN-RC; CONN_PPPC062LJBN-RC_SUL
J7: Micro_SD_Card; microSD_PushPush_TFPUSH-MEM2075
L1: 47uH; L_APV_ANR5040
L2: 10u; L_1008_2520Metric_Pad1.43x2.20mm_HandSolder
Q1: FS8205A; SOT-23-6_Handsoldering
Q2, Q3, Q7, Q8: AO3401A; SOT-23_Handsoldering
Q4: IRLML6346TRPBF; SOT-23
Q5, Q6, Q9: BSS138; SOT-23
R1, R10, R12, R15, R39, R49, R50, R70, R80, R81, R82: 1M; R_0603_1608Metric_Pad0.98x0.95mm_HandSolder
R2, R3: 5.1k; R_0603_1608Metric_Pad0.98x0.95mm_HandSolder
R4, R5, R7, R8, R9, R13, R28, R53, R54, R55, R56, R62, R72: 10k; R_0603_1608Metric_Pad0.98x0.95mm_HandSolder
R6: 4.7k; R_0603_1608Metric_Pad0.98x0.95mm_HandSolder
R11: 12k; R_0603_1608Metric_Pad0.98x0.95mm_HandSolder
R14: 2.2; R_0603_1608Metric_Pad0.98x0.95mm_HandSolder
R16, R78: 1k; R_0603_1608Metric_Pad0.98x0.95mm_HandSolder
R17: 2M; R_0603_1608Metric_Pad0.98x0.95mm_HandSolder
R18: 5.6k; R_0603_1608Metric_Pad0.98x0.95mm_HandSolder
R19: 20k; R_0603_1608Metric_Pad0.98x0.95mm_HandSolder
R20: 56k; R_0603_1608Metric_Pad0.98x0.95mm_HandSolder
R21, R22, R23, R24, R25, R26, R29, R30, R31, R32, R33, R34, R65, R68, R69: 33; R_0603_1608Metric_Pad0.98x0.95mm_HandSolder
R27: 0; R_0805_2012Metric_Pad1.20x1.40mm_HandSolder
R35: 33k; R_0603_1608Metric_Pad0.98x0.95mm_HandSolder
R36: 68k; R_0603_1608Metric_Pad0.98x0.95mm_HandSolder
R37: 15; R_0603_1608Metric_Pad0.98x0.95mm_HandSolder
R38: 300k; R_0603_1608Metric_Pad0.98x0.95mm_HandSolder
R40, R51, R75, R76, R77, R79: 100k; R_0603_1608Metric_Pad0.98x0.95mm_HandSolder
R41: 120k; R_0603_1608Metric_Pad0.98x0.95mm_HandSolder
R42, R43, R44, R45, R46, R52, R58, R66, R73, R74: 0; R_0603_1608Metric_Pad0.98x0.95mm_HandSolder
R47, R48: 2.2k; R_0603_1608Metric_Pad0.98x0.95mm_HandSolder
R57: 10M; R_0603_1608Metric_Pad0.98x0.95mm_HandSolder
R59: 2k; R_0603_1608Metric_Pad0.98x0.95mm_HandSolder
R60, R61, R63, R64, R83: 100; R_0603_1608Metric_Pad0.98x0.95mm_HandSolder
R67: 510k; R_0603_1608Metric_Pad0.98x0.95mm_HandSolder
R71: 200k; R_0603_1608Metric_Pad0.98x0.95mm_HandSolder
SW1, SW2, SW3, SW4, SW5, SW7, SW8, SW9, SW10, SW11: SW_Push; MJTP1117
SW6: SW_Push; SW_PUSH_1P1T_6x3.5mm_H4.3_APEM_MJTP1243
TP1, TP2: TestPoint; TestPoint_Pad_1.0x1.0mm
TP3, TP4, TP5: TestPoint; PinHeader_1x01_P2.54mm_Vertical
U1, U6, U7, U8, U9: TPD4E1U06DBVR; SOT-23-6_Handsoldering
U2: TPS2116DRL; SOT-583-8
U3: TLV75533PDBV; SOT-23-5_HandSoldering
U4: ESP32-S3-WROOM-1
U5: DW01A; SOT-23-6_Handsoldering
U10: TPS923610DRLR; U_DRL0006A_6L_TEX-M
U11: TP4056-42-ESOP8; SOIC-8-1EP_3.9x4.9mm_P1.27mm_EP2.41x3.3mm_ThermalVias
U12: 74LVC1G04; SOT-23-5_HandSoldering
U13: DS3231MZ; SOIC-8_3.9x4.9mm_P1.27mm
U14: RV-8263-C7; MicroCrystal_C7_SON-8_1.5x3.2mm_P0.9mm

Connections:
3V3: C6.1, C10.2, C21.1, C22.2, C24.1, C30.1, C32.1, C33.1, CR2.1 (I/O), J2.15, J2.16, J6.7, L1.2, Q2.2 (S), Q7.2 (S), R4.2, R5.2, R7.1, R13.1, R28.2, R40.2, R42.1, R47.1, R48.1, R66.1, R70.2, R74.1, R81.2, SW10.2, U3.5 (OUT), U4.2 (3V3), U12.5 (VCC), U13.6 (VBAT), U14.5 (VDD)
/COLOR_SEL_INV: Q6.1 (G), U12.4
/DET_NODE: Q2.1 (G), Q9.3 (D), R81.1
/GDR: J2.2, Q4.1 (G), R15.2
/P+_FUSE: CR3.1 (I/O), F2.1, J6.12
/PIN_2: J4.2, R42.2, R43.2
/PIN_4: J4.4, R44.2, R66.2, U7.1
/PIN_5: J4.5, R45.2, R46.2, U7.4
/PIN_6: J4.6, R52.2, R58.2, U7.6
/PR1: R38.2, R51.1, U2.4 (PR1)
/RESE: J2.3, Q4.2 (S), R14.2
B+: J5.2, Q3.2 (S), R57.2, R79.1
B-: C7.2, C34.2, J5.1, Q1.1, Q9.2 (S), R56.2, R80.1, U5.6 (GND)
BAT_MONIT: C8.1, R10.1, R12.2, U4.12 (IO8)
BUTTON_ADC_1: C27.2, R4.1, R18.2, R19.2, R20.2, R60.2, U4.39 (IO1)
BUTTON_ADC_2: C28.2, R11.2, R28.1, R35.2, R36.2, R61.2, U4.4 (IO4)
C-: D8.1 (A1), J3.2, J6.11, Q6.3 (D), R49.1, TP4.1
CC1: J1.A5 (CC1), R3.1, U6.4
CC2: J1.B5 (CC2), R2.1, U6.3
CE: Q2.3 (D), R82.2, U11.8 (CE)
CHRG: R67.1, U11.7 (~CHRG)
COLOR_SEL: Q5.1 (G), R75.1, U4.33 (IO40), U12.2
DN: J1.A7 (D-), J1.B7 (D-), U4.13 (USB_D-), U6.1
DP: J1.A6 (D+), J1.B6 (D+), U4.14 (USB_D+), U6.6
EINK_SW: C11.2, D5.2 (A), L1.1, Q4.3 (D)
EPD_BUSY: J2.9, R34.1
EPD_CS: J2.12, R31.1
EPD_DC: J2.11, R32.1
EPD_RST: J2.10, R5.1, R33.1
ESP32_EN: C5.1, R7.2, R63.2, U4.3 (EN)
ESP32_IO0: R13.2, R64.2, U4.27 (IO0)
GND: C1.1, C2.2, C3.2, C4.2, C5.2, C6.2, C8.2, C9.1, C10.1, C12.1, C13.1, C14.1, C15.1, C16.1, C17.1, C18.1, C19.1, C20.1, C21.2, C22.1, C23.2, C24.2, C25.1, C26.2, C27.1, C28.1, C29.2, C30.2, C31.2, C32.2, C33.2, C36.1, C37.1, CR1.2 (GND), CR2.2 (GND), CR3.2 (GND), D3.2 (A2), D6.1 (K), D8.3 (common), H1.1, H2.1, H3.1, H4.1, H5.1, H6.1, J1.A1 (GND), J1.A12 (GND), J1.B1 (GND), J1.B12 (GND), J2.8, J2.17, J2.S1 (SHIELD), J2.S2 (SHIELD__1), J3.S1 (SHIELD), J3.S2 (SHIELD), J4.1, J4.S1 (SHIELD), J4.S2 (SHIELD), J6.1, J6.4, J7.6 (VSS), J7.9 (SHIELD), Q1.3, Q8.1 (G), R1.1, R2.2, R3.2, R6.2, R10.2, R14.1, R15.1, R16.1, R37.2, R41.2, R49.2, R50.2, R51.2, R59.2, R73.1, R75.2, R76.2, R77.2, R82.1, SW1.1, SW2.1, SW3.1, SW4.1, SW5.1, SW6.1, SW8.1, SW9.1, SW11.1, U1.2, U2.1 (GND), U3.2 (GND), U4.1 (GND), U4.40 (GND), U4.41 (GND), U6.2, U7.2, U8.2, U9.2, U10.4 (GND), U11.1 (TEMP), U11.3 (GND), U11.9 (EPAD), U12.3 (GND), U13.2 (VCC), U13.5 (GND), U14.2 (VSS), U14.3 (CLKOE)
I2C_SCL: J6.10, R45.1, R47.2, R52.1, U4.32 (IO39), U8.3, U13.8 (SCL), U14.7 (SCL)
I2C_SDA: J6.8, R46.1, R48.2, R58.1, U4.31 (IO38), U8.4, U13.7 (SDA), U14.8 (SDA)
LDO_IN: C4.1, C12.2, L2.1, U2.2 (VOUT), U2.7 (VOUT), U3.1 (IN), U3.3 (EN), U10.1 (VIN)
LED_MONIT: C31.1, R39.2, R41.1, U4.38 (IO2)
LED_SW: C9.2, D3.1 (A1), J3.1, J3.5, J6.5, R39.1, TP3.1, U10.5 (VOUT)
unnamed: C13.2, J2.20
unnamed: C15.2, J2.22
unnamed: C17.2, J2.5
unnamed: C18.2, J2.18
unnamed: C19.2, J2.19
unnamed: C20.2, J2.24
unnamed: D2.1 (K), R59.1
unnamed: C11.1, D4.1 (K), D6.2 (A)
unnamed: C1.2, J1.S1 (SHIELD), R1.2
unnamed: Q3.3 (D), R27.2
unnamed: Q3.1 (G), R56.1, R57.1
unnamed: Q5.2 (S), Q6.2 (S), R37.1, U10.3 (FB)
unnamed: Q7.1 (G), R40.1, R78.2
unnamed: Q8.3 (D), R27.1
unnamed: Q9.1 (G), R79.2, R80.2
unnamed: R11.1, SW4.2
unnamed: R18.1, SW3.2
unnamed: R19.1, SW8.2
unnamed: R20.1, SW9.2
unnamed: R35.1, SW5.2
unnamed: R36.1, R72.2, SW7.2
unnamed: R60.1, SW2.2
unnamed: R61.1, SW1.2
unnamed: R62.1, SW10.1
unnamed: R63.1, SW11.2
unnamed: R64.1, SW6.2
unnamed: R73.2, R74.2, SW7.1
unnamed: R68.2, U4.15 (IO3)
unnamed: R26.1, U4.5 (IO5)
unnamed: R25.1, U4.6 (IO6)
unnamed: R24.1, U4.7 (IO7)
unnamed: R29.2, U4.20 (IO12)
unnamed: R30.2, U4.21 (IO13)
unnamed: R31.2, U4.22 (IO14)
unnamed: R23.1, U4.8 (IO15)
unnamed: R22.1, U4.9 (IO16)
unnamed: R21.1, U4.10 (IO17)
unnamed: R32.2, U4.23 (IO21)
unnamed: R69.1, U4.26 (IO45)
unnamed: R65.1, U4.16 (IO46)
unnamed: R33.2, U4.24 (IO47)
unnamed: R34.2, U4.25 (IO48)
unnamed: C34.1, R16.2, U5.2 (CS)
unnamed: Q1.4, U5.3 (OC)
unnamed: Q1.6, U5.1 (OD)
unnamed: C7.1, R83.1, U5.5 (VCC)
unnamed: R6.1, U11.2 (PROG)
P+: C3.1, C26.1, F2.2, Q8.2 (S), R12.1, R83.2, U2.6 (VIN2), U11.5 (BAT)
PREVGH: C14.2, D5.1 (K), J2.21
PREVGL: C16.2, D4.2 (A), J2.23
PWM_LED: U4.35 (IO42), U10.2 (ADIM)
PWR_BUTTON: C29.1, R62.2, R72.1, R76.1, U4.11 (IO18)
RX: TP1.1, U4.36 (RXD0)
SD_ACTIVATE: R78.1, U4.18 (IO10)
SD_CLK: J7.5 (CLK), R24.2, U1.4
SD_CMD: J7.3 (CMD), R23.2, R55.1, U1.6
SD_DAT0: J7.7 (DAT0), R8.1, R25.2, U9.3
SD_DAT1: J7.8 (DAT1), R9.1, R26.2, U9.1
SD_DAT2: J7.1 (DAT2), R21.2, R53.1, U1.3
SD_DAT3: J7.2 (DAT3/CD), R22.2, R54.1, U1.1
SD_VDD: C36.2, C37.2, J7.4 (VDD), Q7.3 (D), R8.2, R9.2, R53.2, R54.2, R55.2, R77.1
SPI_MOSI: J2.14, R29.1
SPI_SCK: J2.13, R30.1
ST: R17.1, U2.8 (ST)
STDBY: R71.1, U11.6 (~STDBY)
TPS_SW_NODE: L2.2, U10.6 (SW)
TP_INT: R43.1, R44.1, U4.34 (IO41)
TP_RST: J4.3, U4.19 (IO11), U7.3
TX: TP2.1, U4.37 (TXD0)
UNUSED_GPIO_3: J6.9, R68.1, U8.6
UNUSED_GPIO_45: J6.3, R69.2, U8.1
UNUSED_GPIO_46: J6.2, R65.2, U9.6
USB_STAT: C23.1, R17.2, R67.2, R70.1, R71.2, U4.17 (IO9)
USB_VBUS: C2.1, C25.2, D2.2 (A), F1.2, R38.1, U2.3 (VIN1), U2.5 (MODE), U11.4 (V_{CC})
VBUS_PRE_FUSE: CR1.1 (I/O), F1.1, J1.A4 (VBUS), J1.A9 (VBUS), J1.B4 (VBUS), J1.B9 (VBUS)
W-: D8.2 (A2), J3.6, J6.6, Q5.3 (D), R50.1, TP5.1
