iandchasse/silkscreen-enclosures/(commit log)

2026-10-21 Silkscreen enclosures: both case projects, print files and showcase
    [battery-connected-mm.stl, board.step, coupon-chin.step, coupon-chin.stl, coupon-gate-x3ls.step, coupon-gate-x3ls.stl, coupon-gate-x3std.step, coupon-gate-x3std.stl]
2026-10-21 README: AI-assisted disclosure at the top, build and print wording fixes; showcase: AI notice, light-strip builds marked in development, neutral download text with a plain browser fallback
2026-10-22 Plate files and projects open in OrcaSlicer 2.3.2 and later; public plate files are generic, released builds only
    OrcaSlicer 2.3.2 and later (through 2.5.0-alpha and main) crash when they open a
    project whose Metadata/project_settings.config has no filament_colour
    (Plater::priv::load_files reads it without a check). No stock preset sets it,
    so every 3MF make_plates.py wrote crashed OrcaSlicer: both plate files and every
    per-configuration project, generic and CC2.
    - project_settings() now writes OrcaSlicer's whole key set
    (enclosures/orca-project-defaults.json, made by `make_plates.py defaults` with
    the OrcaSlicer CLI), the flattened presets over it, and filament_colour, one
    entry per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
    [silkscreen-368-plates.3mf, silkscreen-426-plates.3mf]
2026-10-22 Docs and showcase: name board parts in plain words, keep designators as labels; plate numbers and OrcaSlicer version wording corrected
    [compare.py]
2026-10-22 Showcase: plain names in the remaining text (reset, ribbons, side keys, joint, USB, files, board prep); longer drawing labels fit their drawings
2026-10-22 3.68 power rework: remove R62 (SW10's old series resistor) along with R36 and R73, then fit R72 and R74; showcase rebuilt
    [hw.py]
2026-10-22 Showcase board prep: remove R36, R73 and R62 first, then fit R72 and R74; heading counts five resistors
2026-10-22 board-trim.md: the rework removes three parts (R36, R73, R62)
2026-10-23 USB port fits board Rev 1.0 and Rev 1.02: hole and divot board-side edges one layer out, 3.68 lid block one layer lower
    Rev 1.02's SMD USB4105 opening sits 0.14 mm nearer the board than Rev 1.0's USB4085, and KiCad seats both about 0.085 mm
    deeper than a real board rests. As printed, a Rev 1.02 plug touched the port hole's board-side edge in both cases.
    - both tubs: the hole's board-side edge onto a layer line from the face (4.26 -0.575 -> -0.40, 3.68 -0.575 -> -0.33);
    the divot's board-side edge likewise (4.26 1.045 -> 1.20, 3.68 -> 1.27), its lead-in with it
    - 3.68 lid: the port block top one layer lower (-3.335 -> -3.435), off a mid-plane tie
    - asprinted.usb_fit, run by both slice_chec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
    [lid.step, lid.stl, silkscreen-368-plates.3mf, silkscreen-426-plates.3mf, tub-chinless.step, tub-chinless.stl, tub-light-strip-chinless.step, tub-light-strip-chinless.stl]
2026-10-23 Docs: the 3.68 divot edge printed at 1.07 before; the lid block moved one 0.2 mm layer as printed
2026-10-23 Add the checks for the community edit's changes (they fail on main)
    community.py (both cases) checks the six decisions of 2026-10-23 with their literal numbers: no seam V, side pads 1.2 proud,
    plain pins on the midplate, the wordmark on the back above the grooves and a plain chin, the two-colour inlays filling their
    recesses, and the 4.26 top screw's relief. build.py runs it on every build (community.json); slice_check reads the pins, the
    logos and the top screw's pilot as laid. asprinted.PILOT_R is (0.5, 1.0) in both cases so a 2.4 clearance bore is not read as
    pilot. Run on main's built parts every row fails, as intended.
    [asprinted.py, build.py, community.py, params.py, pipeline.py, slice_check.py]
2026-10-23 Port the community member's edit: no seam V, side pads 1.2 proud, plain midplate pins, wordmark on the back, top screw relief, two-colour inlays
    A community member edited the 4.26 standard case in Onshape; Ian took six of the changes (2026-10-23). They are re-made here in
    CadQuery from measurements, in both cases where they apply:
    - the parting line is square on both halves (SEAM_CHAMFER 0, the key bars' own V derived from it);
    - the side key pads stand 1.2 proud (was 1.5), our 45-degree faces kept;
    - the midplate's snap posts are plain d1.90 pins (BOARD_SNAP style 'pole', tip -1.00, rounded), the barb style kept as an option;
    - the wordmark moves from the chin to the lid's back above the gr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
    [bayread.py, build.py, community.py, crank_checks.py, lid.py, logo.py, mechanics.py]
2026-10-23 Two-colour projects (make_plates, configs_slice read-back), showcase text and guards, docs for the community edit's changes
    make_plates.py writes the opt-in two-colour projects: the plate files print/silkscreen-426-plates-2colour.3mf and -368-, and per configuration
    <slug>-2colour.3mf with recipes and index-2colour.json (generic only). The lid goes alone on a plate of its own with the two inlays as parts on
    filament 2; project_settings(filaments=2) writes the second filament, the colours, and a small prime tower in a free corner. configs_slice.two_colour
    slices that plate and reads it back by tool. The showcase adapters and cards no longer name the V, the chin wordmark or the snap posts, and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
    [configs_slice.py]
2026-10-23 3.68 print files: tub, lid, midplate, coupons and the two logo inlays for the community edit's changes
    Rebuilt with build.py: the tubs and coupons lose the seam V and the chin wordmark, the lid gains the wordmark on the back and 1.2 mm pads, the midplate has plain pins; lid-inlay-wordmark and lid-inlay-icon are new. Keys and cranks changed only in OCC byte noise and are kept as they were.
    [coupon-gate-x3ls.step, coupon-gate-x3ls.stl, coupon-gate-x3std.step, coupon-gate-x3std.stl, coupon-strip-x3ls.step, coupon-strip-x3ls.stl, coupon-strip-x3std.step, coupon-strip-x3std.stl]
2026-10-23 Fix round: two-colour supports stay filament 1, enforcer bounds check back under side_keys, glyph polygons without rtree, doc numbers
    [configs_slice.py, params.py, tub.py]
2026-10-24 4.26 print files, plate files (generic and two-colour), two-colour read-back made depth-aware and recalibrated on the first in-lid slices
    [coupon-chin.step, coupon-chin.stl, coupon-gate.step, coupon-gate.stl, crank-M.step, crank-T.step, key-426.step, lid-chinless-inlay-icon.step]
2026-10-24 print/4.26: crank-M, crank-T and key-426 STEPs back to main's bytes (OCC header noise only)
    [crank-M.step, crank-T.step, key-426.step]
2026-10-24 4.26 lid: H2, H5 and H6 posts one layer short of the board (H1 on it, H5 pin keeps its reach); drop the dead midplate spring at (53, 102); slice_check reads the post tops as laid
    [lid.py, midplate.py, params.py, slice_check.py]
2026-10-24 print/4.26: lid, lid-chinless and midplate STEPs/STLs and both plate files for the lowered posts and the dropped Y-102 spring
    [lid-chinless.step, lid-chinless.stl, lid.step, lid.stl, midplate.step, midplate.stl, silkscreen-426-plates-2colour.3mf, silkscreen-426-plates.3mf]
2026-10-24 Docs: 4.26 README section on the lowered lid posts and the dropped Y-102 spring, print reprint note, open-work update, post-section picture
2026-10-24 Showcase rebuilt for the bulge fix (closing card, six springs, Emily B credited); CLAUDE.md lists the new post read-back
2026-10-24 Two-colour logo as a switch: one plate file per size, one project per configuration
    Every lid in both public plate files, the CC2 plate files and all 33 projects (generic and CC2) now carries its two logo
    bodies as modifier parts of the lid object with no setting of their own, named so the object list says what they are. A modifier
    with nothing set changes nothing, so the default job is the single-colour lid as before (OFF read back against a no-logo
    control). Change type -> Part and Change filament -> 2 on the two parts turn the logo on (filament 2 only in the first two
    layers, inside the glyphs).
    The projects define two filaments, have the prime tower off (a modifier that carries a filame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
    [silkscreen-368-plates-2colour.3mf, silkscreen-368-plates.3mf, silkscreen-426-plates-2colour.3mf, silkscreen-426-plates.3mf]
2026-10-24 Docs: the logo switch's menu names as OrcaSlicer shows them (Set Filament for selected items; Multimaterial -> Prime tower), OFF time within a few seconds
2026-10-24 Docs: switch the logo parts to Part one at a time (ElegooSlicer and OrcaSlicer 2.3.x have no Change type for a multi-selection); Ian checked the clicks in ElegooSlicer
2026-11-01 Slide cover: geometry for the three envelopes, the case readers, the fit coupons and the plate-file builder
    enclosures/cover/ builds one slide-on cover per case envelope (4.26 with bottom keys, 4.26 chinless, 3.68 standard) and three
    fit coupons of the end channel with its snap prong. Reads each case's envelope, rounds, key caps and side keys from its params
    and built STLs (case_info.py); nothing under case-426/src or case-368/src is touched. Not printed.
2026-11-01 Slide cover: the print files, the cover plate file and the checks against the real case STLs
    print/cover/4.26 and print/cover/3.68 (not print/4.26 or print/3.68: both case builds delete any file there they did not make):
    cover-keyed, cover-chinless, cover-standard and the fit coupons A, B, C (4.26) and the 3.68's. print/silkscreen-cover-plates.3mf:
    coupons first, then one plate per cover, generic OrcaSlicer presets through make_plates' own functions. check.py (33 builds, both
    orientations, swept slide path, ridge deflection from the real end faces, access), snap.py (beam estimates), printcheck.py and
    slice_read.py (OrcaSlicer CLI read-back: no supports). Not printed.
    [cover-chinless.step, cover-chinless.stl, cover-coupon-A.step, cover-coupon-A.stl, cover-coupon-B.step, cover-coupon-B.stl, cover-coupon-C.step, cover-coupon-C.stl]
2026-11-01 Slide cover: README, pictures, the print/README entry, the case README pointers, OPEN-WORK and CLAUDE.md
    Untested: nothing is printed. Print the fit coupons first.
2026-11-01 Slide cover: STEP files in the case's CAD frame, the 3.68 coupon marked 3, a display-glass row in check.py
    The .step files were written in the print frame; they are now the cover (and coupon) on the front of the case at its drawn pose, as every
    other STEP in print/. The 3.68 coupon carries a 3 so it cannot be mistaken for the 4.26's coupon A. check.py: the plate to the display glass
    seen through the window (2.2 over the relief, 1.35 at the relief's edge). 33 builds, 1140 rows, 0 failing. Not printed.
    [cover-chinless.step, cover-coupon-A.step, cover-coupon-B.step, cover-coupon-C.step, cover-coupon.step, cover-coupon.stl, cover-keyed.step, cover-standard.step]
2026-11-01 Slide cover round 2: logo engraving, rounded edges, four poses, scalloped sides
    The three covers (4.26 keyed, 4.26 chinless, 3.68) rebuilt after Ian printed coupon A and
    found the fit fine (channel, lip, prong thickness profile, root, length, ridge height and
    ramps unchanged).
    - the case's own back icon and wordmark engraved in the outer face, read at run time from each
    case's logo.py and params.py (logo_dump.py), plus the two inlay bodies for the two-colour
    switch (print/cover/*-inlay-*.stl)
    - every touchable edge rounded: 0.6 chamfer round the outer-face perimeter, fillets of 0.5 and
    up elsewhere, R3 open-end corners (R1.5 where a key slot leaves), the prong's free end fully
    round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
    [cover-chinless-inlay-icon.stl, cover-chinless-inlay-wordmark.stl, cover-chinless.stl, cover-coupon-A.step, cover-coupon-A.stl, cover-coupon-B.step, cover-coupon-B.stl, cover-coupon-C.step]
2026-11-01 Slide cover round 2: checks in four poses, fingertip, logo, sharp edges, snap comparison
    - check.py: every build the covers serve in all four poses (front, back, each turned 180
    degrees in the plane): home, swept slide, play, key slots at both ends, USB-C, the ridge's
    deflection read through the cover's own mesh, the screen overlap of the scalloped plate, the
    r 7 fingertip sweep to every pad face, the engraving over the case's logo and the plate
    behind it; --wrong (one-ended key slot, 16 mm corner extension, ridge in J6's band must
    fail); --snap (27bbdaf against round 2)
    - edges.py: the sharp-edge scan (convex edges over 50 degrees, grouped, touchable or not),
    run on 27bbdaf's co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
    [silkscreen-cover-plates.3mf]
2026-11-01 Slide cover round 2: pictures and docs
    Pictures: front and back at home, the four poses, a turned pose part way on, the scallop with a
    side key and a fingertip, the open end and prong (27bbdaf next to round 2), the logo face as
    printed with the two-colour bodies, the snap corner. README, print/README, OPEN-WORK and
    CLAUDE.md updated: coupons gone, temporary plate file, the sharp-edge result with what remains
    and why, the snap before/after, what was checked and what was not printed.
2026-11-01 Slide cover phase 2 geometry: solid plate, flared slot roofs, border lines, rounded tab, uniform slit
    - the plate is solid over the screen (no relief): keyed 2.8, chinless 2.4 (was 1.8), 3.68 3.0; rest gap to the glass 1.37 mm
    - the key slots' cutters flare 45 degrees at the mouth, so the roof leaves the face in a bevel (no 90-degree edge)
    - two engraved border lines (0.8 wide, 0.4 deep) 2.5 and 4.5 mm in from the plate's outline, 5.5 mm from the logos
    - the snap tab's side outline is a rounded tongue (R5 top arc, R4 end, 45-degree chamfer to the bed) inside phase 1's footprint
    (tip 0.4 mm past the ridge's start; 72.0 mm wide, was 72.11); the ridge's lead-in is trimmed to it, the flat top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
    [cover-chinless-inlay-icon.stl, cover-chinless-inlay-wordmark.stl, cover-chinless.step, cover-chinless.stl, cover-keyed-inlay-icon.stl, cover-keyed-inlay-wordmark.stl, cover-keyed.step, cover-keyed.stl]
2026-11-01 Slide cover phase 2: checks, pictures and docs
    - check.py: rest gap to the glass, footprint, border-line and tongue rows, --angle (the push-on's contact angle at first touch along the
    swept path: 18.5 degrees in all four poses), --plate (Navier plate estimate of the press that touches the glass)
    - edges.py counts the border lines' rims with the engraving rims; slice_read.py probes the tongue and the taper
    - run of record on the final STLs: 2511 rows over 33 builds, 0 failing; --wrong, --snap, printcheck, both slices, inlay_check
    - pictures: the open-end corner phase 1 next to phase 2 from the outer face, the side and the case side; the whole outer face
    - README, print/README, OPEN-WORK, CL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
    [silkscreen-cover-plates.3mf]
2026-11-02 Slide cover phase 3: rounded-rectangle border, less Y room, firmer snap
    Ian printed the phase-2 cover: the border lines should be a rounded
    rectangle, the fit was not quite there (room top to bottom a tiny bit
    tighter, more so on the 3.68), the snap tab a bit more secure.
    - Border: two concentric lines (R4 / R2), straight sides along the
    scallop's narrow middle, straight ends 1.0 mm clear of the slits.
    - Y room: channel walls 0.30 -> 0.20 (3.68: 0.15), corner pieces
    0.20 -> 0.14 (0.12) off the R5 arcs. play.py measures the rigid Y
    travel at home: 0.338 -> 0.234 mm (3.68: 0.165); the stop end's
    corner pieces set it, not the walls. Z travel held at phase 2's
    0.709 (lip face clearanc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
    [cover-chinless-inlay-icon.stl, cover-chinless-inlay-wordmark.stl, cover-chinless.step, cover-chinless.stl, cover-keyed-inlay-icon.stl, cover-keyed-inlay-wordmark.stl, cover-keyed.step, cover-keyed.stl]
2026-11-02 Put the slide covers on the case plates and into every project
    make_plates.py places each build's cover (keyed, chinless, 3.68) on a
    plate with room for it, the plate's own spacing rules applied, in the
    public plate files, the CC2 plate files and every per-configuration
    project (generic and CC2, 4.26 and 3.68). Keyed covers go on the APEM
    crank-M plate, chinless covers on a new plate 2 of their own, the 3.68's
    on the APEM plate (generic) or the lid's plate (CC2). Each cover carries
    its two logo bodies as modifier parts (switch OFF), like the lid.
    configs_slice.py: the logo-switch read-back reads every plate that
    carries logo parts (the lid's and the cover's); --no-logo-switch skips it.
    plat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
    [silkscreen-368-plates.3mf, silkscreen-426-plates.3mf]
2026-11-07 Add two optional colour switches: front chin lines and side keys in a second colour
    Both are modifier parts with no setting (off by default), like the two-colour logo, written
    into every plate file and per-configuration project by make_plates.py:
    - Three lines on the tub's front chin (the idea is from juno_last's case design): 1.0 mm wide,
    2.5 mm pitch, 48 mm long, 0.6 mm (3 layers) deep from the front face, centred between the
    bottom-key openings and the window edge. 4.26 builds with bottom keys and the 3.68 standard;
    Negative Volume engraves them, filament 2 colours them. Bodies: print/4.26 and print/3.68
    tub-front-lines.stl, made and checked against each tub by enclosures/color_o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
    [silkscreen-368-plates.3mf, silkscreen-426-plates.3mf, tub-front-lines.stl]
2026-11-07 Drop the side-key colour box; put the three front lines on every tub
    The lid box modifier is removed (lids are as at e2870ae). The lines now also go on the chinless
    tubs (4.26 chinless and light-strip chinless), centred between the window's bottom edge and the
    case's bottom edge: same 1.0 wide, 2.5 pitch, 48 long, 0.6 deep, off by default. The 3.68
    light-strip tub stays without. Docs, checks and pictures updated.
    [silkscreen-368-plates.3mf, silkscreen-426-plates.3mf, tub-front-lines-chinless.stl]
2026-11-07 Front lines: one modifier part per tub; the 3.68 light-strip tub gets them too
    The three line shells are merged into one modifier_part per tub (one click per switch).
    The 3.68 light-strip tub now carries the lines (shared 3.68 STL, checked against both tubs).
    Docs and color_check.py updated.
    [silkscreen-368-plates.3mf, silkscreen-426-plates.3mf]
2026-11-07 Front lines: engraved by default
    The tub's front lines part now ships as a Negative Volume, so the three
    lines print as 0.6 mm grooves in the case colour with one filament.
    Change type -> Modifier gives no lines; that modifier with filament 2
    gives flush lines in a second colour. color_check.py tests the shipped
    state and both switches (4.26 standard and chinless, 3.68, CC2 light
    strip: all OK).
    [silkscreen-368-plates.3mf, silkscreen-426-plates.3mf]
2026-11-08 Logos: widen the thin strokes so the two-colour logo slices whole
    Ian: with the logo switched on, the CC2's classic walls left the thinnest
    strokes bare (the icon's diagonal page lines, the e's crossbar, the thin
    tops of the s, c and e).
    - Wordmark: weight 0.12, a uniform outward offset (every stroke 0.24
    wider, letterforms and the e's holes kept). Ink 40.34 x 7.36.
    - Icon: logo.min_stroke, a thin-only variable offset. Strokes under 0.7
    grow toward 0.7, each edge by 0.15 at most; wider strokes, corners and
    the gaps between parallel lines do not move. Outline unchanged.
    - Both cases (identical logo.py), so every lid, the slide covers, their
    logo bodies, the plate files and the projec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
    [cover-chinless-inlay-icon.stl, cover-chinless-inlay-wordmark.stl, cover-chinless.step, cover-chinless.stl, cover-keyed-inlay-icon.stl, cover-keyed-inlay-wordmark.stl, cover-keyed.step, cover-keyed.stl]
