iandchasse/silkscreen-enclosures/(notices)

Notices in the files:
enclosures/case-426/hardware/board-2026-09-21/silkscreen_pcb.kicad_pcb:
Licensed under CERN-OHL-S-2.0
showcase/API.md:
`cmp_*` | extras | the Xteink X4 and its retro case. The **X4 reference model** is by Zorian22 (Thingiverse thing:7287950, CC BY-NC-SA); the retro case comes from its author's print files (`compare.py` headers). Keep the attribution.
naming Zorian22 and CC BY-NC-SA. On `368 ls` a line says the X4 models stand level with the standard build's face.
Zorian22's (Thingiverse thing:7287950, CC BY-NC-SA) and the retro case came from its author's print files. The
(thing:7287950, CC BY-NC-SA) and the retro case to its author's print files, as `compare.py` says; the same wording
